AUV-VITP/isonavi-rov/docs/isonavi_rov_report.tex

\documentclass[10pt,a4paper]{article}

\usepackage[margin=22mm]{geometry}
\usepackage{amsmath,amssymb}
\usepackage{graphicx}
\usepackage{booktabs}
\usepackage{longtable}
\usepackage{caption}
\usepackage{xcolor}
\usepackage{titlesec}
\usepackage{enumitem}
\usepackage{fancyhdr}
\usepackage{siunitx}
\usepackage[hidelinks]{hyperref}

\newcommand{\INR}[1]{Rs.\,#1}

\definecolor{accent}{HTML}{16407A}

\titleformat{\section}{\normalfont\Large\bfseries\color{accent}}{\thesection}{0.6em}{}
\titleformat{\subsection}{\normalfont\large\bfseries}{\thesubsection}{0.6em}{}

\pagestyle{fancy}
\fancyhf{}
\lhead{\small\color{accent}isonavi-rov \textbar{} Technical Design Report}
\rhead{\small\thepage}
\renewcommand{\headrulewidth}{0.4pt}

\renewcommand{\topfraction}{0.92}
\renewcommand{\bottomfraction}{0.85}
\renewcommand{\textfraction}{0.06}
\renewcommand{\floatpagefraction}{0.80}
\setcounter{topnumber}{3}
\setcounter{bottomnumber}{2}
\setcounter{totalnumber}{5}

\captionsetup{font=small,labelfont={bf,color=accent}}
\sisetup{detect-all}
\setlist{nosep,leftmargin=1.4em}

\input{rov_metrics.tex}

\newcommand{\keyfig}[3]{%
  \IfFileExists{#1}{%
    \begin{figure}[htbp]\centering
    
    \caption{#2}\label{#3}
    \end{figure}}{}}
\newcommand{\widthfig}[4]{%
  \IfFileExists{#1}{%
    \begin{figure}[htbp]\centering
    
    \caption{#2}\label{#3}
    \end{figure}}{}}

\begin{document}

\begin{titlepage}
\centering
\vspace*{0.35cm}
{\color{accent}\rule{\linewidth}{1.2pt}}\\[4mm]
{\Huge\bfseries isonavi-rov}\\[3mm]
{\Large A tethered, piloted underwater vehicle for confined water}\\[2mm]
{\color{accent}\rule{\linewidth}{1.2pt}}\\[6mm]

{\large Technical Design Report}\\[3mm]
{\normalsize Vehicle, power, safety, vision and pilot assist, and the simulation that sizes them}\\[8mm]

\begin{minipage}{0.86\linewidth}
\small
\textbf{Summary.} This report covers the simulation study of isonavi-rov on
its parametric reference vehicle: a
\SI{\mmass}{\kilo\gram}, \mlenoverall{} by \mbeam{} by \mheight{}~cm open frame
ROV, powered and controlled over a \SI{50}{\metre} tether, that threads a
\SI{1}{\metre} gate, finds and touches a coloured target in an unlit pool by
its own light, and flies a three section walled maze. The reference carries
eight vectored thrusters; the build carries six on six ESCs, and the layout is
a parameter of the budget, so every result here reruns on it.

The design is closed by analysis rather than chosen: mass, buoyancy and
trim are solved from a component list and checked against a CAD model built
from the same list; the power path is sized to a governed peak; and the
thrusters are matched to their propeller. Four pilot modes, manual,
assisted, the camera alone in the lateral loop, and shared, where the
camera's correction and the pilot's stick are blended by the error each has,
are flown through the course in simulation with a modelled human operator,
across water clarities and forty random course layouts, and scored on
contacts, target and time. The vehicle-side software then runs on a hardware-in-the-loop
bench over a framed, CRC-checked protocol, and reproduces the simulation.
\end{minipage}

\vspace{3mm}
\IfFileExists{../simulation/vehicle/isonavi_rov_hero.png}{}{}

\vspace{3mm}
\begin{minipage}{0.94\linewidth}
\centering\footnotesize
\renewcommand{\arraystretch}{1.05}
\begin{tabular}{@{}lc@{\hspace{7mm}}lc@{}}
\toprule
Mass, envelope & \SI{\mmass}{\kilo\gram}, \mlenoverall{} x \mbeam{} x \mheight{} cm &
Contacts per run, murky: assist, shared & \mrefassistmurkycontacts{}, \mrefsharedmurkycontacts{} \\
Surge force, one unit lost & \SI{\msurgelost}{\newton} &
Contacts per run, turbid: assist, shared & \mrefassistmidcontacts{}, \mrefsharedmidcontacts{} \\
Governed input, peak current & \SI{\mcapw}{\watt}, \SI{\mpeakamps}{\ampere} &
Target colour, \SI{1}{\metre}, murky water & \midmurkyone{}\,\% \\
Link loss to zero thrust & \SI{\mholdtime}{\second} &
Cost, vehicle with tether and surface & \INR{\mcostbuild} \\
\bottomrule
\end{tabular}
\end{minipage}

\vfill
{\small Every number in this report is generated from the result files\\
by a script in the repository that accompanies it\\[1mm]
\texttt{github.com/AUV-VITP/isonavi-rov}}
\end{titlepage}

\tableofcontents
\newpage

% ======================================================================
\section{Requirements}

The vehicle is designed against the following, which together describe a
piloted pool task: pass a submerged gate without touching it, identify a
target by colour in an unlit pool and touch it, and fly a walled maze while
touching as little as possible.

\begin{table}[htbp]\centering\small
\begin{tabular}{@{}lll@{}}
\toprule
Requirement & Value & How it is met \\
\midrule
Mass in air & below \SI{35}{\kilo\gram}, target below \SI{20}{\kilo\gram} & \SI{\mmass}{\kilo\gram}, Section~\ref{sec:budget} \\
Envelope & target below 75 x 65 x 60 cm & \mlenoverall{} x \mbeam{} x \mheight{} cm over the probe \\
Power & 230 V 50 Hz mains, fused & \msupplyv{} V supply, \SI{\mfuse}{\ampere} fuse, Section~\ref{sec:power} \\
Emergency stop & external kill switch & four layer chain, Section~\ref{sec:safety} \\
Tether & about \SI{50}{\metre} & power pair and Cat5e, neutrally buoyant \\
Pool & 20 x 10 m, 0.6 to 1.8 m deep & arena model, Section~\ref{sec:arena} \\
Gate & \SI{1}{\metre} clear opening & beam \SI{\mbeam}{\centi\metre} \\
Maze walls & up to \SI{1.5}{\metre} high, covered passage & arena model \\
Leaks and pollution & none & no battery aboard, sealed hull, leak probes \\
Compressed gas, lasers & none carried & not applicable \\
\bottomrule
\end{tabular}
\caption{Design requirements and where each is closed.}\label{tab:req}
\end{table}

% ======================================================================
\section{Vehicle}\label{sec:budget}

\keyfig{../simulation/vehicle/isonavi_rov_views.png}{General arrangement, from the CAD model
built out of the solved budget. Four horizontal thrusters canted at 45 degrees
give surge, sway and yaw; four vertical thrusters give heave, roll and pitch.
The vehicle can move sideways without turning, which is how it crosses the
slalom without widening its swept path.}{fig:views}

\subsection{Mass, buoyancy and trim are solved}

Every component is listed with a mass, a displaced volume and a station
(\texttt{simulation/vehicle/rov.py}). Three things are then solved rather than chosen: the
foam volume, so the vehicle floats \SI{\mnetbuoy}{\newton} positive and rises
if power is lost; the lead ballast, so the centre of gravity sits
\SI{\mbg}{\milli\metre} below the centre of buoyancy and the vehicle rights
itself; and the foam station, so it floats level (trim offset
\SI{\mtrim}{\milli\metre}). The result is \SI{\mmass}{\kilo\gram} and
\SI{\mdisplaced}{\litre} with \SI{\mfoam}{\litre} of foam and
\SI{\mballast}{\kilo\gram} of lead.

\subsection{The CAD checks the budget}

\texttt{simulation/vehicle/rov\_cad.py} builds the \mcadparts{}-part assembly from the solved
budget and checks it three ways. The displaced volume of each group as built
agrees with the budget: buoyancy \SI{\mcadbuoybuilt}{\litre} and hull
\SI{\mcadhullbuilt}{\litre} exactly, the rest to within items not modelled as
solids (fasteners, cables, the depth sensor). The assembly fits a
\mcadenvl{} x \mcadenvb{} x \mcadenvh{} cm box. And every part is tested
against every other for overlap: \mcadclash{} pairs overlap, the closest
thruster duct clears a side plate by \SI{\mcadplate}{\milli\metre}, and the
foam blocks \SI{\mcadoutflow}{\milli\litre} of the worst vertical thruster's
outflow.

The check earned its place. The first build found the vertical ducts
touching the side plates, which moved their station inboard by
\SI{15}{\milli\metre}; displaced volumes for the ducts, skids and end caps
that the budget had underestimated; a probe that protrudes
\SI{6}{\centi\metre} past the frame and therefore had to be in the contact
model; lamps that overlapped the front horizontal ducts; and a kill switch
inside the foam. Each was fixed in the budget, not only in the drawing, and
the simulation re-run.

\subsection{Hydrodynamics and thrust}

Damping and added mass are scaled from the tank-identified coefficients of
the BlueROV2 Heavy, an open frame vehicle of the same class, by projected area and
displaced volume. With \mthrustmax{}~N thrusters the vehicle makes
\SI{\msurgefull}{\newton} in surge and sway and \SI{\mheavefull}{\newton} in
heave, for \SI{\mspeedfull}{\metre\per\second} ahead.

The course is flown at \SI{\mopsspeed}{\metre\per\second}. There, the tether
is a third of the load: \mtrail{} m of trailing tether adds
\SI{\mtetherdrag}{\newton} to the frame's \SI{\mframedrag}{\newton}. With any
one thruster lost, a linear program over the surviving seven still makes
\SI{\msurgelost}{\newton} with zero net moment, a margin of \mopsmargin{} over
that load. That margin is what set the thrust target at \mthrustmax{}~N.

The tether drag acts where the tether is terminated, so the termination sits
at the height of the centre of gravity, on a post between the two rear cross
members: \SI{\mtowarm}{\milli\metre} from the CG height, the drag at operating
speed holds \mtowpitch$^\circ$ of pitch against the righting moment of the
BG, which the attitude hold barely has to answer.

The horizontal thrusters sit \SI{\mthrhz}{\milli\metre} below the CG, so
surge thrust pitches the vehicle: at the full surge envelope that is
\SI{\msurgepitchmoment}{\newton\metre} against a righting moment that peaks at
$m g\,BG$, and uncorrected it would hold the vehicle about \msurgepitchdeg{}
degrees nose up. The allocation therefore takes every moment about the CG with
the thrusters at their real heights, and answers surge with the verticals; the
envelope above already pays for it. The python dynamics had left the heights
out until the Gazebo model (Section~\ref{sec:gazebo}), which places the
thrusters where the CAD has them, made the coupling visible.

\subsection{Thrusters, made in house}

Each thruster is a hobby outrunner run flooded, with a potted stator, in a
printed Kort duct with a \SI{76}{\milli\metre} three blade propeller. The
motor is matched to the propeller rather than picked by habit
(\texttt{simulation/vehicle/thruster.py}): at the bench point the propeller turns at about
\mkvrpm{}~rpm, far below where a high KV winding wants to run, so the motor
works at low speed and high torque. A 1000~KV winding would carry
\SI{\mkvthousandphase}{\ampere} of phase current, past 80\,\% of a
\SI{30}{\ampere} controller. The \mkvchosen{}~KV winding carries
\SI{\mkvphase}{\ampere} and draws \SI{\mkvinput}{\watt}, and its motor and
propeller efficiencies together reproduce the drive efficiency the power path
was sized on. The propellers are printed in left and right hand pairs so their
reaction torques cancel; the dynamics leave propeller torque out, which holds
only with them paired.

% ======================================================================
\section{Power and tether}\label{sec:power}

A 48 V mains supply at the poolside is set to \SI{\msupplyv}{\volt}, inside
its 43 to 55 V adjustment and below its over-voltage threshold, and that runs
down two paralleled \SI{2.5}{\milli\metre\squared} cores per leg (loop
resistance \SI{\mloopohm}{\ohm}) to two converters aboard that feed the
thruster rail. The higher voltage carries the same power on less current, and
tether loss goes with the square of the current. There is no battery on the
vehicle.

All eight thrusters at full draw \SI{\muncapped}{\watt}, which would need a
\SI{40}{\ampere} fuse and a supply to match. That is not a design point, so a
governor in the allocator caps input at \SI{\mcapw}{\watt}. Propeller power
from momentum theory is homogeneous of degree $3/2$ in thrust, so scaling
every thruster by $k$ scales the total by $k^{3/2}$ and the $k$ that meets the
cap is exact in one step. At the cap all eight together still make
\SI{\mcapthrust}{\newton} each, the current is \SI{\mpeakamps}{\ampere}, the
converters see \SI{\mvinpeak}{\volt} against a \SI{36}{\volt} floor, and the
tether dissipates \SI{\mtetherloss}{\watt}. The surface supply is
\SI{\msupplyw}{\watt} and the main fuse \SI{\mfuse}{\ampere}, at 1.25 times
the governed peak current. Fifty metres is inside the \SI{100}{\metre} reach
of plain Ethernet, so the data pair is Cat5e with no modem.

At the governed peak the converters lose \SI{\mconvloss}{\watt} as heat inside
the sealed acrylic tube, where still air and the acrylic wall both conduct
poorly. An aluminium plate carries it from the converters to the rear end
cap, which is machined aluminium and in the water.

% ======================================================================
\section{Safety chain}\label{sec:safety}

Four layers, each able to stop the thrusters on its own:
\begin{enumerate}
\item a fused mains supply with an emergency stop on its output;
\item an external magnet kill switch on the vehicle that opens the thruster rail;
\item the supervisor on the flight computer, which zeroes thrust on a kill, a
leak, or \SI{\mholdtimeout}{\second} without a pilot packet, and latches the
kill and leak states;
\item the ESP32, whose firmware drops every channel to neutral if the flight
computer goes quiet.
\end{enumerate}
The vehicle floats positive, so zero thrust is the safe state: from the
deepest point of the pool it rises unpowered. On the hardware-in-the-loop
bench (Section~\ref{sec:hil}) a \SI{10}{\second} loss of pilot packets put
the board in HOLD \SI{\mholdtime}{\second} after the last packet, one control
tick after the timeout, with zero thrust throughout and a rise of
\SI{\mholdrise}{\metre}; packets returning re-armed it. A kill latched on the
tick it arrived and held zero thrust for all \mkillticks{} ticks that
followed, through continuing pilot traffic.

% ======================================================================
\section{Arena and camera}\label{sec:arena}

\subsection{Arena}

The pool is \SI{20}{\metre} by \SI{10}{\metre}, its floor sloping from
\SI{0.6}{\metre} to \SI{1.8}{\metre}. The course is a gate of two posts and a
crossbar with a \SI{1}{\metre} opening; four balloons of different colours on
a line, one of which is the target; and a three section maze, a straight
corridor, a slalom between posts, and a covered passage, with walls up to
\SI{1.5}{\metre} high. Placement is parametric, and the results are reported
both for a reference layout and for forty layouts drawn at random. Each
element carries a signed distance function, and the hull and probe are
sampled as points, so a contact is any sample on or inside an element.

\subsection{Camera image formation}

In an unlit pool the only light is what the vehicle carries. Per pixel and
per colour channel, with $c$ the attenuation coefficient, $\beta$ the volume
backscatter coefficient, $\rho$ the surface albedo, $t$ the range along the
ray and $r_l$ the lamp to point range,
\begin{align*}
L &= \frac{\rho}{\pi} \sum_{\text{lamps}} I_0\, b(\theta) \cos i\, \frac{e^{-c r_l}}{r_l^2}\, e^{-c t}, &
B &= \int_0^t \beta \sum_{\text{lamps}} I_0\, b(\theta_s) \frac{e^{-c r_l(s)}}{r_l(s)^2}\, e^{-c s}\, ds .
\end{align*}
Red is absorbed several times faster than blue, so colour fails before
detection does, and the backscatter integral is evaluated along every ray, so
lamp placement shows in the image the way it does in a real one. Water clarity
is set by the scattering coefficient $b$: $0.05$ per metre for a clear pool,
$0.4$ for a turbid one and $1.0$ for murky water.

\keyfig{../simulation/results/figures/r3_camera_views.png}{The onboard camera
at the same pose in three water clarities, rendered by the camera model. In
murky water the balloons are still there; their colour is not.}{fig:cam}

% ======================================================================
\section{Vision}

\subsection{Target colour, without training data}

A fixed colour threshold works at one range in one water and nowhere else, so
the target finder undoes the water instead. It removes the backscatter veil,
segments what remains into round blobs, takes range from apparent size
against the known target radius, multiplies each channel by $e^{2cr}$ to undo
the two way attenuation at that range, and matches the corrected chromaticity
to the nearest reference. A blob whose size implies a range the lamps cannot
light is speckle and is rejected; left in, the correction at that range turns
it any colour.

With the lamps as built, \SI{0.18}{\metre} either side of the lens, the target
colour is identified at \SI{1}{\metre} in \midclearone{}, \midmidone{} and
\midmurkyone{}\,\% of frames in clear, turbid and murky water, and at
\SI{1.5}{\metre} in \midclearonehalf{}, \midmidonehalf{} and
\midmurkyonehalf{}\,\%. Lamp placement matters: at \SI{1.5}{\metre} in turbid
water, lamps \SI{0.10}{\metre} off the lens identify \mlampnarrowmid{}\,\% and
lamps as built \mlampbuiltmid{}\,\%. The operating rule that follows is to
close to about a metre before committing to a colour.

\keyfig{../simulation/results/figures/r2_target_identification.png}{Target
colour identified correctly against range, by water clarity and lamp
placement, from rendered frames at jittered poses.}{fig:id}

\subsection{Where the vehicle is on the course, from the image}

The camera-alone and shared modes measure the vehicle's position across the
course from each frame at \SI{5}{\hertz}, in \texttt{vision.}\allowbreak\texttt{CourseEstimator}:
\begin{itemize}
\item \textbf{gate and obstacles}: posts are found as narrow bright columns.
With the distance to the post known, each bearing, rotated by the IMU heading,
gives the lateral offset, and an object elsewhere in the frame is rejected by
its bearing. One offset has to explain every column at once, so a far post is
not paired with a near one. At the gate both posts must be in the frame and
each must have its own column; otherwise the frame gives no measurement.
Without that rule, once one post had left the edge of the frame close to the
gate, the fit took a lone column far beyond it for the missing post and
steered the vehicle towards the post it could no longer see; in murky water
that was behind every gate contact traced in the random layouts;
\item \textbf{target}: bearing and range from size of the detection of the
target colour;
\item \textbf{corridor}: a lamp-lit wall dims as the square of its distance,
so the log ratio of left to right wall brightness is
$s = 2 \ln\frac{w/2 + y}{w/2 - y}$ for an offset $y$ in a corridor of width
$w$. Inverted, $y = \frac{w}{2}\tanh(g s/4)$ plus a heading term; the gain
and heading term are fitted per water clarity on rendered frames from random
layouts and tested on held-out frames.
\end{itemize}
Every estimator is tested on rendered frames called exactly as the closed loop
calls it; the gate frames come from random layouts, so what lies beyond the
gate is in the test. These held-out errors are also what the shared mode
weights the camera by.

\begin{table}[htbp]\centering\small
\begin{tabular}{@{}lccc@{}}
\toprule
RMS lateral error, mm & $b = 0.05$ & $b = 0.4$ & $b = 1.0$ \\
\midrule
Corridor, straight section & \mwallclearstraight & \mwallmidstraight & \mwallmurkystraight \\
Corridor, covered passage & \mwallclearpassage & \mwallmidpassage & \mwallmurkypassage \\
Corridor walls, slalom section & \mwallclearobstacles & \mwallmidobstacles & \mwallmurkyobstacles \\
Posts, slalom section & \mpostsclear & \mpostsmid & \mpostsmurky \\
Gate posts at \SI{1}{\metre} & \mgateclearone & \mgatemidone & \mgatemurkyone \\
Target at \SI{1}{\metre} & \mtgtclearone & \mtgtmidone & \mtgtmurkyone \\
\bottomrule
\end{tabular}
\caption{Lateral position error of the course estimators on held-out rendered
frames. The slalom posts disturb the wall ratio, which is why that section
uses the posts. At the gate, a measurement comes back in \mgateclearoneavail,
\mgatemidoneavail{} and \mgatemurkyoneavail\,\% of frames at
\SI{1}{\metre}.}\label{tab:est}
\end{table}

% ======================================================================
\section{Pilot in the loop}

The vehicle is flown by a person looking at the camera feed, so the question
is what a pilot with a reaction time, video latency and an imperfect read of
the picture achieves, and how much the vehicle's own loops change that. The
operator is a crossover model: stick commands are a gain on the perceived
error plus a lead term, delayed by \SI{0.25}{\second} of reaction and
\SI{0.15}{\second} of video latency, with motor noise on the stick. The
pilot's read of the course degrades with range and with the two way
attenuation of the vehicle's own light over it.

\begin{description}
\item[manual] sticks map to thrust; the pilot also flies depth and attitude,
which on a positively buoyant vehicle is constant work.
\item[assist] depth hold from the pressure sensor and heading and attitude
hold from the IMU; vertical speed is taken from the depth signal, not from
the simulator. The pilot steers in the horizontal plane only.
\item[camera] the assist loops plus the course estimators in the lateral loop,
rendered from the camera model every \SI{0.2}{\second}. Open water legs, with
nothing to see or hit, are held on heading, and progress along the course is
taken as known. On the vehicle the ROS~2 layer runs the corridor part of this
mode, which needs only the corridor width; gate and target guidance need the
course geometry, which the pilot supplies.
\item[shared] the assist loops, with the pilot's lateral command blended with
the camera's, each weighted by the inverse of its error variance: the
estimator's held-out error for that section and range (Table~\ref{tab:est})
against the spread of the pilot's read at that range and clarity. In clear
water close in, the pilot's read is the better one and the camera's share is
small; in murky water at range, the reverse. The camera's share is formed
aboard and does not wait for the video delay, and a frame with no measurement
leaves the pilot's command alone.
\end{description}
The camera's estimate is differenced at the control rate, so its rate acts
in the tick a frame arrives. Smoothing it first with an alpha-beta tracker was
tried and added contacts in both camera modes: the estimate does carry frame
to frame noise, but the lag the tracker adds cost more than the noise it took
out. The ROS~2 pilot node differences the same way.
Runs are scored on what an observer records: contacts as events, the gate
passed clean or not, the right target touched with the probe or not, and time.

% ======================================================================
\section{Results}

\subsection{Reference layout}

\begin{table}[htbp]\centering\small
\begin{tabular}{@{}lccccc@{}}
\toprule
Mode, water & Finished & Gate clean & Right target & Contacts per run & Time, s \\
\midrule
manual, $b = 0.05$ & \mrefmanualcleardone/\mrefmanualclearn & \mrefmanualcleargate & \mrefmanualclearhit & \mrefmanualclearcontacts{} $\pm$ \mrefmanualclearcontactsd & \mrefmanualcleartime \\
manual, $b = 0.4$ & \mrefmanualmiddone/\mrefmanualmidn & \mrefmanualmidgate & \mrefmanualmidhit & \mrefmanualmidcontacts{} $\pm$ \mrefmanualmidcontactsd & \mrefmanualmidtime \\
manual, $b = 1.0$ & \mrefmanualmurkydone/\mrefmanualmurkyn & \mrefmanualmurkygate & \mrefmanualmurkyhit & \mrefmanualmurkycontacts{} $\pm$ \mrefmanualmurkycontactsd & \mrefmanualmurkytime \\
assist, $b = 0.05$ & \mrefassistcleardone/\mrefassistclearn & \mrefassistcleargate & \mrefassistclearhit & \mrefassistclearcontacts{} $\pm$ \mrefassistclearcontactsd & \mrefassistcleartime \\
assist, $b = 0.4$ & \mrefassistmiddone/\mrefassistmidn & \mrefassistmidgate & \mrefassistmidhit & \mrefassistmidcontacts{} $\pm$ \mrefassistmidcontactsd & \mrefassistmidtime \\
assist, $b = 1.0$ & \mrefassistmurkydone/\mrefassistmurkyn & \mrefassistmurkygate & \mrefassistmurkyhit & \mrefassistmurkycontacts{} $\pm$ \mrefassistmurkycontactsd & \mrefassistmurkytime \\
camera, $b = 0.05$ & \mrefautocleardone/\mrefautoclearn & \mrefautocleargate & \mrefautoclearhit & \mrefautoclearcontacts{} $\pm$ \mrefautoclearcontactsd & \mrefautocleartime \\
camera, $b = 0.4$ & \mrefautomiddone/\mrefautomidn & \mrefautomidgate & \mrefautomidhit & \mrefautomidcontacts{} $\pm$ \mrefautomidcontactsd & \mrefautomidtime \\
camera, $b = 1.0$ & \mrefautomurkydone/\mrefautomurkyn & \mrefautomurkygate & \mrefautomurkyhit & \mrefautomurkycontacts{} $\pm$ \mrefautomurkycontactsd & \mrefautomurkytime \\
shared, $b = 0.05$ & \mrefsharedcleardone/\mrefsharedclearn & \mrefsharedcleargate & \mrefsharedclearhit & \mrefsharedclearcontacts{} $\pm$ \mrefsharedclearcontactsd & \mrefsharedcleartime \\
shared, $b = 0.4$ & \mrefsharedmiddone/\mrefsharedmidn & \mrefsharedmidgate & \mrefsharedmidhit & \mrefsharedmidcontacts{} $\pm$ \mrefsharedmidcontactsd & \mrefsharedmidtime \\
shared, $b = 1.0$ & \mrefsharedmurkydone/\mrefsharedmurkyn & \mrefsharedmurkygate & \mrefsharedmurkyhit & \mrefsharedmurkycontacts{} $\pm$ \mrefsharedmurkycontactsd & \mrefsharedmurkytime \\
\bottomrule
\end{tabular}
\caption{Course runs on the reference layout, 20 seeds per row.}\label{tab:ref}
\end{table}

Every run in every row finished, passed the gate clean and touched the right
target, so the rows differ in contacts and time. A pilot's contacts are set
by the water. In clear and turbid water a manual pilot averages under one
contact a run and the assist cuts that further, because the pilot no longer
flies depth and attitude. At $b = 1.0$ the pilot's read of the corridor fails
with the two way attenuation of the vehicle's own light, and contacts rise to
\mrefmanualmurkycontacts{} manual and \mrefassistmurkycontacts{} assisted,
with a spread as large as the mean; over the twenty assisted runs,
\mrefassistmurkywallhits{} contacts are with the maze walls and
\mrefassistmurkyposthits{} with the slalom posts.

The camera alone behaves the other way: \mrefautoclearcontacts{},
\mrefautomidcontacts{} and \mrefautomurkycontacts{} contacts a run at the
three clarities, with a small spread, because its error comes from the
estimators, which depend little on clarity, and not from a read that fails
with range. Its contacts are at the first two slalom posts. The gap beside a
post is \SI{\mslalomgap}{\centi\metre}, which leaves the
\SI{\mbeam}{\centi\metre} beam \SI{\mslalomside}{\milli\metre} a side when
centred, and there the wall ratio, which assumes two plain walls, is
disturbed by the posts (\SI{\mwallmidobstacles}{\milli\metre} RMS at
$b = 0.4$ against \SI{\mwallmidstraight}{\milli\metre} in the straight
section), and the post fit is available in \mpostsmidavail\,\% of frames.

The shared mode takes the better of the two wherever it is on the course.
Paired seed by seed against the assist, its contacts a run differ by
$\mrefcleardiffassist \pm \mrefcleardiffassistse$ in clear water,
$\mrefmiddiffassist \pm \mrefmiddiffassistse$ in turbid water and
$\mrefmurkydiffassist \pm \mrefmurkydiffassistse$ in murky water (mean
and standard error): no worse where the pilot can see, and in murky water the
wall contacts all but go (\mrefsharedmurkywallhits{} over twenty runs). What
remains, in every mode that flies the course well, is the first two slalom
posts.

\keyfig{../simulation/results/figures/r1_course_tracks.png}{Tracks of one seed
in each mode, in turbid and murky water; auto is the camera alone. Crosses
mark contacts.}{fig:tracks}

\subsection{Random layouts}

\begin{table}[htbp]\centering\small
\begin{tabular}{@{}lccccc@{}}
\toprule
Mode, water & Finished & Gate clean & Right target & Contacts per run & Time, s \\
\midrule
manual, $b = 0.4$ & \mlaymanualmiddone/\mlaymanualmidn & \mlaymanualmidgate & \mlaymanualmidhit & \mlaymanualmidcontacts{} $\pm$ \mlaymanualmidcontactsd & \mlaymanualmidtime \\
manual, $b = 1.0$ & \mlaymanualmurkydone/\mlaymanualmurkyn & \mlaymanualmurkygate & \mlaymanualmurkyhit & \mlaymanualmurkycontacts{} $\pm$ \mlaymanualmurkycontactsd & \mlaymanualmurkytime \\
assist, $b = 0.4$ & \mlayassistmiddone/\mlayassistmidn & \mlayassistmidgate & \mlayassistmidhit & \mlayassistmidcontacts{} $\pm$ \mlayassistmidcontactsd & \mlayassistmidtime \\
assist, $b = 1.0$ & \mlayassistmurkydone/\mlayassistmurkyn & \mlayassistmurkygate & \mlayassistmurkyhit & \mlayassistmurkycontacts{} $\pm$ \mlayassistmurkycontactsd & \mlayassistmurkytime \\
camera, $b = 0.4$ & \mlayautomiddone/\mlayautomidn & \mlayautomidgate & \mlayautomidhit & \mlayautomidcontacts{} $\pm$ \mlayautomidcontactsd & \mlayautomidtime \\
camera, $b = 1.0$ & \mlayautomurkydone/\mlayautomurkyn & \mlayautomurkygate & \mlayautomurkyhit & \mlayautomurkycontacts{} $\pm$ \mlayautomurkycontactsd & \mlayautomurkytime \\
shared, $b = 0.4$ & \mlaysharedmiddone/\mlaysharedmidn & \mlaysharedmidgate & \mlaysharedmidhit & \mlaysharedmidcontacts{} $\pm$ \mlaysharedmidcontactsd & \mlaysharedmidtime \\
shared, $b = 1.0$ & \mlaysharedmurkydone/\mlaysharedmurkyn & \mlaysharedmurkygate & \mlaysharedmurkyhit & \mlaysharedmurkycontacts{} $\pm$ \mlaysharedmurkycontactsd & \mlaysharedmurkytime \\
\bottomrule
\end{tabular}
\caption{Forty random layouts per row: gate and target line placement, colour
order, which colour is the target, corridor width and slalom offsets all
vary.}\label{tab:lay}
\end{table}

Forty random layouts give the same picture, paired layout by layout. In
turbid water the shared mode is level with the assist
($\mlaymiddiffassist \pm \mlaymiddiffassistse$ contacts a run) and with the
manual pilot ($\mlaymiddiffmanual \pm \mlaymiddiffmanualse$); in murky water it makes
$\mlaymurkydiffassist \pm \mlaymurkydiffassistse$ against the assist and
$\mlaymurkydiffmanual \pm \mlaymurkydiffmanualse$ against the manual pilot,
and the assist's
\mlayassistmurkywallhits{} wall contacts fall to \mlaysharedmurkywallhits.
The gate was passed clean and the right target touched in every run of every
mode; a wrong balloon was touched on the way in a few times (in turbid water
\mlaymanualmidwrong{} manual and \mlaysharedmidwrong{} shared runs of
\mlaysharedmidn).

The operating rule that follows is to fly shared throughout. It asks the pilot
for no decision about when the water is too murky to trust their eyes: the
weighting makes that decision from the water clarity, which is a setting,
measured from camera frames in the pool before a run.

% ======================================================================
\section{Hardware in the loop}\label{sec:hil}

The bench splits the loop the way the vehicle is wired. The host is the world
and the surface station: it holds the pool, the true dynamics and the sensor
models, runs the pilot, and sends the sensor sample and the pilot packet each
tick. The board is the vehicle: it runs the hold loops, the allocation, the
governor and the supervisor on what it receives and returns the wrench the
thrusters produce. It never sees the course or the truth. The protocol is
a framed, CRC-checked link with two message types for the pilot
command and the supervisor report; a lost pilot packet is emulated by an
acknowledgement in its place, which keeps the bench deterministic.

Over the link, an assisted course finished in \SI{\mhiltime}{\second} against
\SI{\msimtime}{\second} in the pure simulation, with the same contact count
(\mhilcontacts) and a largest position difference of
\SI{\mhildev}{\metre} over \mhilticks{} ticks, which is re-allocation round
off and nothing else. The safety results are in Section~\ref{sec:safety}.
The board and the ESP32 actuator interface have run this protocol on
hardware; this bench ran over localhost, and the next step is the same run on
the boards.

% ======================================================================
\section{Gazebo model}\label{sec:gazebo}

The vehicle also runs in Gazebo Harmonic under ROS~2 Jazzy, with the same
nodes it flies on, against the pool world. Neither the model nor the world is
written by hand: \texttt{make\_model.py} builds the vehicle from the solved
budget and the CAD, and \texttt{make\_world.py} builds the pool from the arena
the course runs use, for the reference or any random layout.

\begin{itemize}
\item \textbf{mass and inertia}: from the budget, about the CG, which is the
link origin as it is the origin of the python dynamics; the eight propeller
links the thruster plugin needs are taken out of the hull's share, so the
totals are the budget's;
\item \textbf{added mass}: integrated implicitly by the physics engine. The
hydrodynamics plugin's own added mass is explicit, and diverges when the
heave added mass exceeds the dry mass, as it does here;
\item \textbf{buoyancy}: Gazebo integrates the volume of the collision shapes,
which are also what a post or a wall meets. The contact shapes are the parts
that can be met, at their real sizes, the side plates at the thickness that
leaves their pocketed volume; one shape that touches nothing carries the rest
of the budgeted volume, placed so the total and its centre are the budget's
displaced volume and centre of buoyancy;
\item \textbf{thrusters}: the stations and axes are checked against the
allocation matrix when the model is written. The plugin spins each propeller
by setting its joint speed; driving it through joint torque, the plugin's
default, twists the hull with the reaction;
\item \textbf{tether}: the course runs' tether drag, applied at the tow point
every physics step from inside Gazebo;
\item \textbf{depth}: from the pose with the depth cell's noise and rate.
Gazebo has no water pressure sensor; its air pressure sensor reads the
atmosphere.
\end{itemize}

\begin{table}[htbp]\centering\small
\begin{tabular}{@{}llc@{}}
\toprule
Case, open loop & Quantity & RMS difference \\
\midrule
Rise, zero thrust & depth & \SI{\mtwinrisez}{\milli\metre} \\
Heave, verticals pushing down & depth & \SI{\mtwinheavez}{\milli\metre} \\
Surge & position, speed & \SI{\mtwinsurgex}{\milli\metre}, \SI{\mtwinsurgeu}{\milli\metre\per\second} \\
Surge & pitch & \mtwinsurgepitch$^\circ$ \\
Roll, released at \ang{20} & roll & \mtwinrollroll$^\circ$ \\
Surge with the tether & position, speed & \SI{\mtwintetherx}{\milli\metre}, \SI{\mtwintetheru}{\milli\metre\per\second} \\
\bottomrule
\end{tabular}
\caption{The Gazebo model against the python dynamics, same thruster forces
from the same start, compared every \SI{20}{\milli\second}. The python
thrusters apply their command at once here, as Gazebo's do.}\label{tab:twin}
\end{table}

\keyfig{../simulation/results/figures/r4_gazebo_twin.png}{The Gazebo model
(dashed) against the python dynamics, open loop.}{fig:twin}

The two agree to well inside a millimetre in translation; roll differs most,
by a fraction of a degree over a swing of \mtwinrollspan$^\circ$. With the model
checked, \texttt{test\_sim.sh} flies the nodes on it: an assisted surge stick
moves the vehicle forward at its held depth, and silence on the pilot link
holds every thruster at zero. Gazebo renders the camera without water, with
no absorption or backscatter, so the vision results stay with the camera
model of Section~\ref{sec:arena}; the Gazebo camera is for the plumbing.

% ======================================================================
\section{Software}

\begin{itemize}
\item \texttt{simulation/isonavi}: arena, camera, vision, pilot, safety, with
the dynamics, sensors and geometry they build on;
\item \texttt{ros/isonavi\_rov\_ros}: ROS~2 nodes for the pilot assist, the
safety chain, the actuator interface and vision, each a thin wrapper over the
module the simulation verified. The pilot node runs the shared mode's blend in
the corridor with the same functions the simulation uses, from the worst wall
section's error and the pilot's read at \SI{1.5}{\metre}, the middle of the
operator model's look-ahead along a corridor leg: the camera's share is
\mrosweightclear, \mrosweightmid{} and \mrosweightmurky{} in clear, turbid and
murky water. Built under Jazzy and run end to end: with
the gamepad live the actuator node emits the expected pulse widths, and when
it stops the supervisor reports HOLD and every channel goes to neutral;
\item \texttt{ros/isonavi\_rov\_description}, \texttt{ros/isonavi\_rov\_gazebo}:
the Gazebo model and pool world, their generators, the tether and depth
adapters and the check of Section~\ref{sec:gazebo};
\item \texttt{hil}: the bench in Section~\ref{sec:hil};
\item \texttt{simulation/vehicle}: budget, CAD and its checks, thruster match, bill of materials.
\end{itemize}

% ======================================================================
\section{Cost}

Prices are in rupees including GST, each line with the basis it rests on
(\texttt{simulation/vehicle/rov\_bom.py}).

\begin{table}[htbp]\centering\small
\begin{tabular}{@{}lr@{}}
\toprule
Group & Rupees \\
\midrule
Propulsion, eight thrusters & \mcostpropulsion \\
Hull & \mcosthull \\
Frame, foam and ballast & \mcostframe \\
Electronics & \mcostelectronics \\
\midrule
Vehicle & \mcostvehicle \\
Tether & \mcosttether \\
Surface station & \mcostsurface \\
\midrule
Vehicle, tether and surface & \mcostbuild \\
Test equipment and practice pool time & \mcosttest \\
Contingency & \mcostcont \\
\midrule
\textbf{Total} & \textbf{\mcosttotal} \\
\bottomrule
\end{tabular}
\caption{Cost by group. \minhouselines{} of \mbomlines{} lines are made in
house: the thrusters, end caps, frame, buoyancy, lamp housings, kill switch,
thermal bridge, tether floats and the thrust rig.}\label{tab:cost}
\end{table}

% ======================================================================
\section{Verification and what remains}

Verified in simulation: the mass, buoyancy and trim budget against the CAD;
the thrust envelope with a unit lost; the power path at the governed peak;
target identification and the course estimators on rendered frames; the
course in four modes across water clarities and random layouts. Verified on
the bench: the vehicle-side software reproducing the simulation over the
link, and the safety chain under link loss and kill. Verified in Gazebo: the
vehicle model against the python dynamics, and the nodes flying it closed
loop.

What needs water, in order:
\begin{enumerate}
\item a thrust curve for every thruster on the rig before it is fitted,
against the \mthrustmax{}~N target;
\item a vacuum test of the sealed hull, then a dunk test;
\item trim in a tank, against the solved foam and ballast;
\item camera frames in the pool to calibrate the attenuation coefficient and
the corridor gain, which the simulation takes from its model;
\item pilot hours on a mock course, which also measure the pilot's read
error that the shared mode weights the camera against.
\end{enumerate}
The hydrodynamic coefficients are scaled from a reference vehicle rather than
measured, and the operator model stands in for a real pilot; both are
replaced by measurement in the steps above.

\end{document}
