AUV-VITP/isonavi-rov/cad/solidworks/ASSem/Gripper/gripper_012645.png

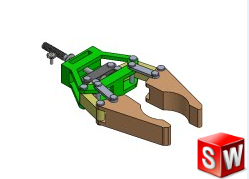
cad/solidworks/ASSem/Gripper/gripper_012645.png
