AUV-VITP/isonavi-rov/cad/solidworks/ASSem/Gripper/gripper_012656.png

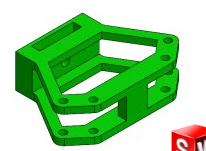
cad/solidworks/ASSem/Gripper/gripper_012656.png
