AUV-VITP/isonavi-rov/cad/solidworks/ASSem/Gripper/gripper_012730.png

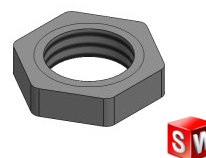
cad/solidworks/ASSem/Gripper/gripper_012730.png
