AUV-VITP/isonavi-rov/cad/solidworks/ASSem/Gripper/gripper_012734.png

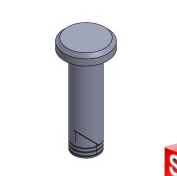
cad/solidworks/ASSem/Gripper/gripper_012734.png
