AUV-VITP/isonavi-rov/docs/media/architecture.jpeg

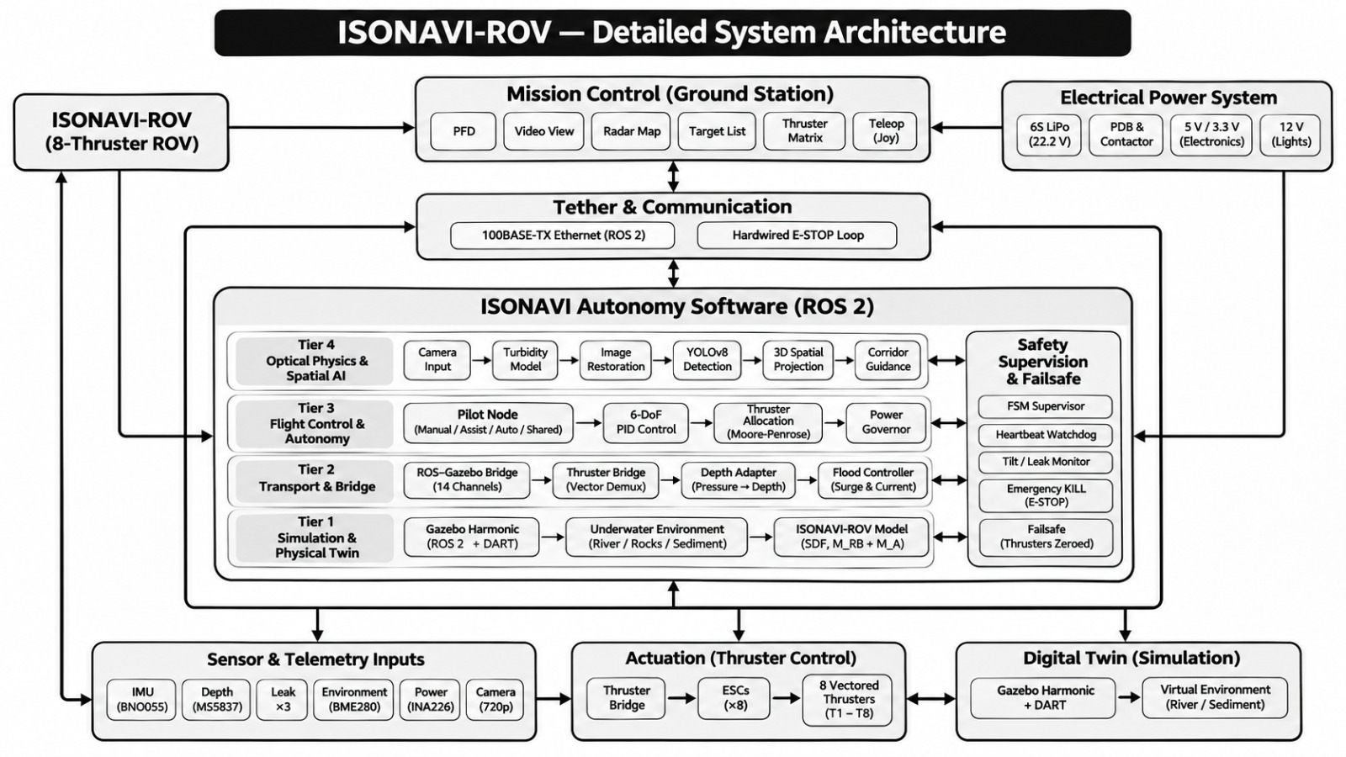
docs/media/architecture.jpeg
