AUV-VITP/isonavi-rov/docs/media/working_principle.jpeg

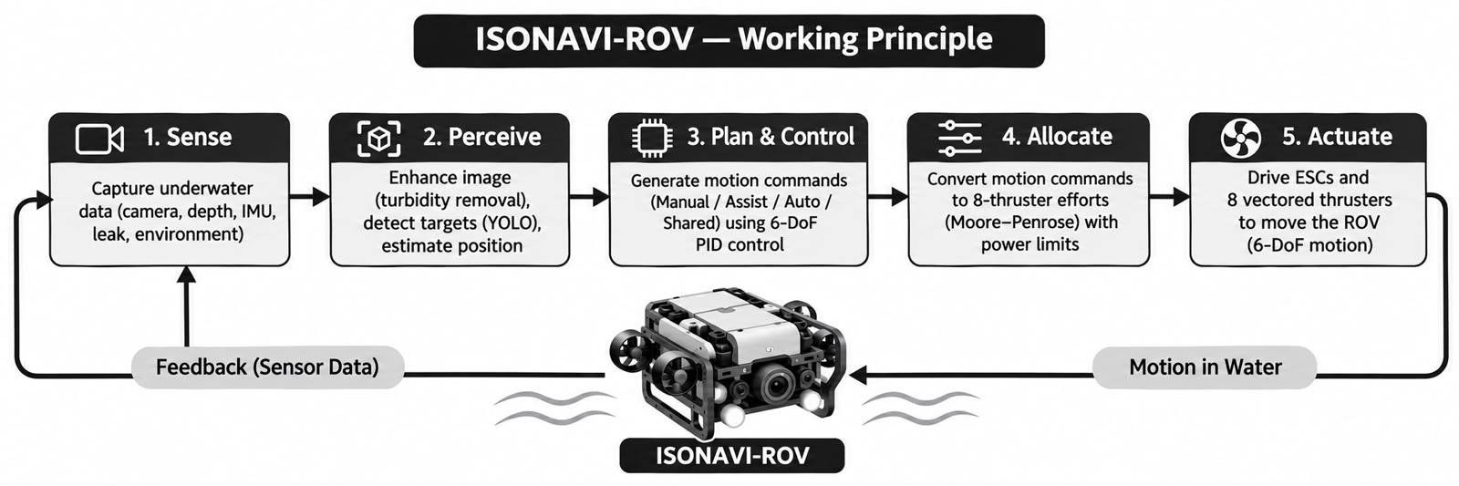
docs/media/working_principle.jpeg
