AUV-VITP/isonavi-rov/cad/solidworks/ASSem/BATT-SLED.SLDASM

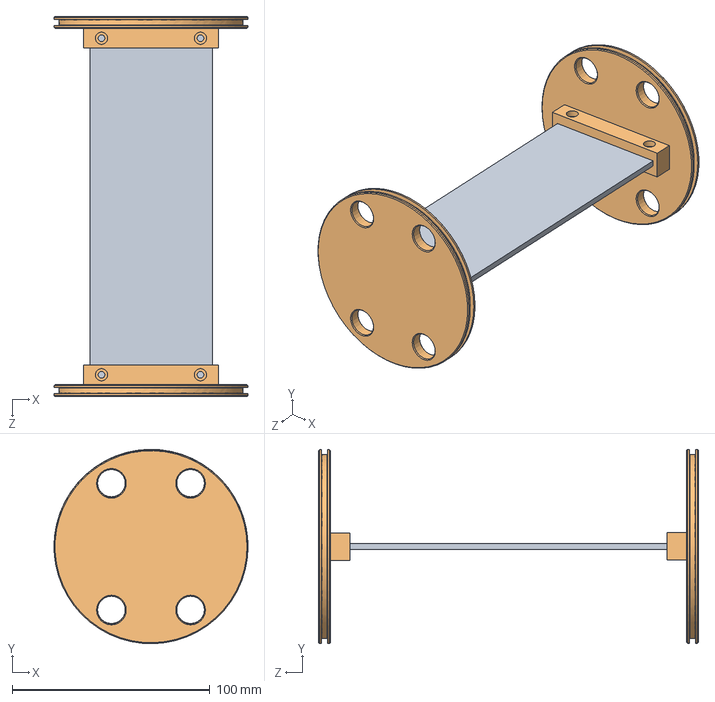
[picture p26: CAD file, 2026-11-10]
cad/solidworks/ASSem/BATT-SLED.SLDASM
98.0 x 98.2 x 192.0 mm
CAN-005_Disc - BATT x 2
CAN-004_Spine - BATT
