AUV-VITP/isonavi-rov/cad/solidworks/ASSem/MAIN.SLDASM

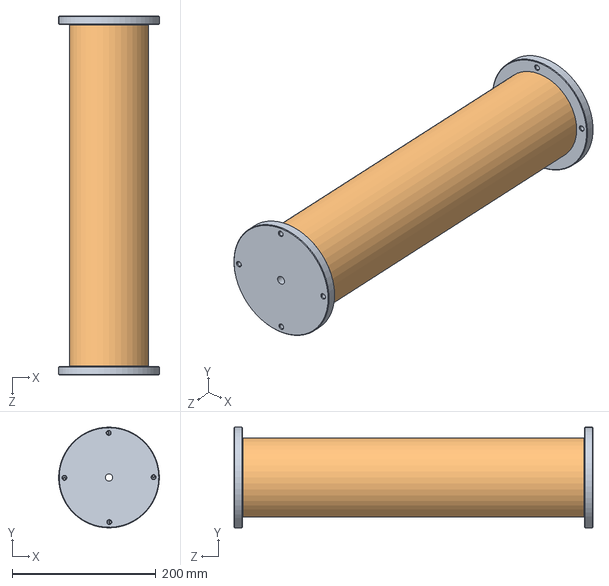
[picture p27: CAD file, 2026-11-10]
cad/solidworks/ASSem/MAIN.SLDASM
140.0 x 140.0 x 499.0 mm
CAN-001
CAN-003_Cap x 2
