AUV-VITP/isonavi-rov/cad/solidworks/ASSem/Gripper/Assem1.SLDASM

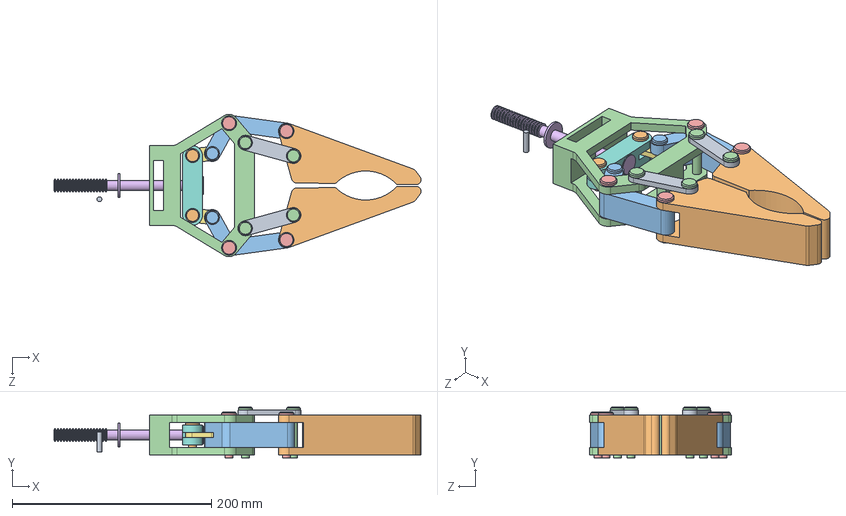
[picture p28: CAD file, 2026-11-10]
cad/solidworks/ASSem/Gripper/Assem1.SLDASM
368.2 x 51.0 x 143.0 mm
Bracket
Jaw Connctor x 2
Jaw x 2
connctor Big x 2
Slider
connctor small x 2
shift
pin2 x 4
pin3 x 4
pin4 x 2
pin1 x 2
crank
