AUV-VITP/isonavi-rov/cad/isonavi_rov.step

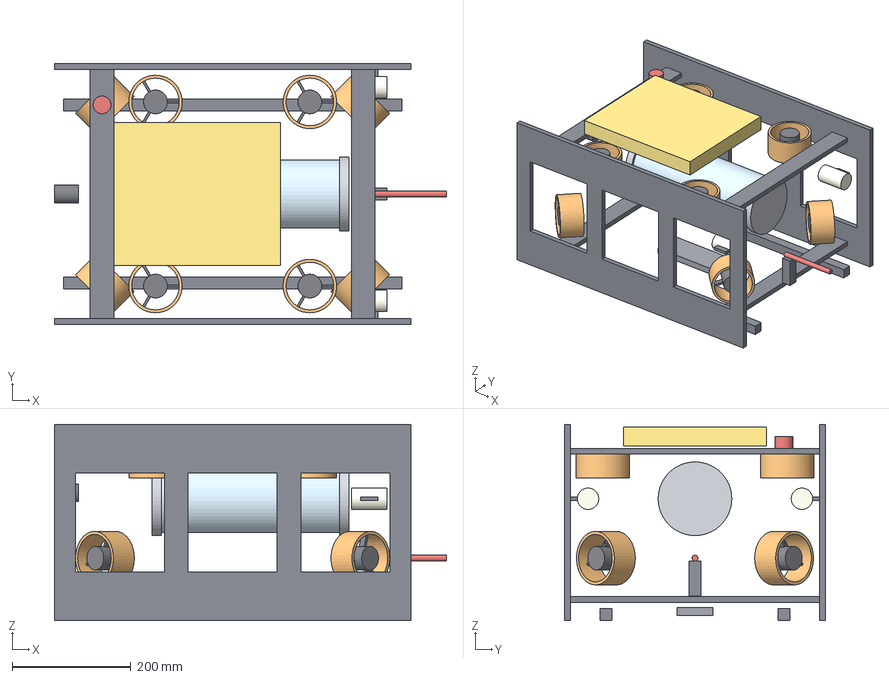
[picture p29: CAD file, 2026-10-23]
cad/isonavi_rov.step
660.0 x 440.0 x 330.0 mm
side plate port
side plate stbd
cross member 1
cross member 2
cross member 3
cross member 4
skid port
skid stbd
hull tube
end cap rear
end cap front
thruster h1 duct
thruster h1 pod
thruster h2 duct
thruster h2 pod
thruster h3 duct
thruster h3 pod
thruster h4 duct
thruster h4 pod
thruster v1 duct
thruster v1 pod
thruster v2 duct
thruster v2 pod
thruster v3 duct
thruster v3 pod
thruster v4 duct
thruster v4 pod
buoyancy foam
trim ballast
lamp port
lamp bracket port
lamp stbd
lamp bracket stbd
touch probe
probe bracket
kill switch
tether termination
