AUV-VITP/isonavi-rov/cad/solidworks/ASSem/Gripper/pin1.SLDPRT

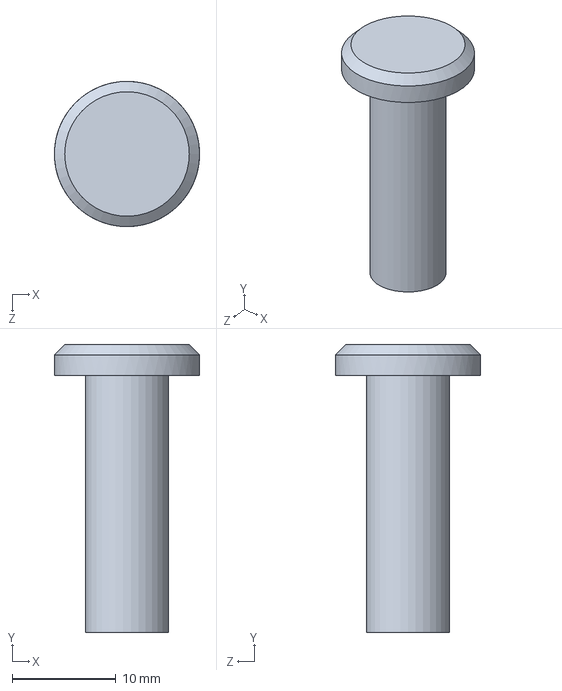
[picture p30: CAD file, 2026-11-10]
cad/solidworks/ASSem/Gripper/pin1.SLDPRT
14.0 x 27.8 x 14.0 mm
