AUV-VITP/isonavi-rov/ros/isonavi_rov_description/models/isonavi_rov/meshes/part_2.stl

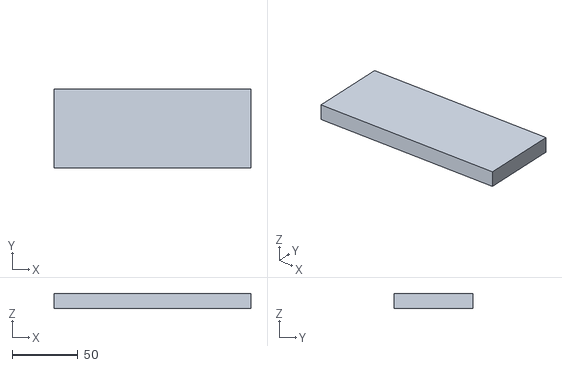
[picture p32: CAD file, 2026-10-25]
ros/isonavi_rov_description/models/isonavi_rov/meshes/part_2.stl
150.0 x 60.0 x 11.6
