AUV-VITP/isonavi-rov/cad/solidworks/ASSem/Gripper/Jaw Connctor.SLDPRT

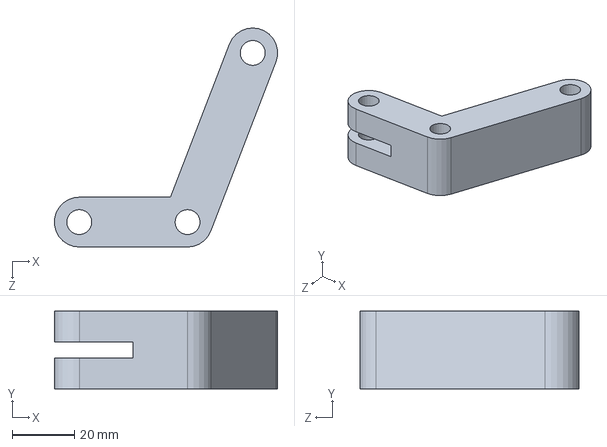
[picture p33: CAD file, 2026-11-10]
cad/solidworks/ASSem/Gripper/Jaw Connctor.SLDPRT
71.5 x 25.0 x 70.2 mm
