AUV-VITP/isonavi-rov/cad/solidworks/Parts/FRAME 1.SLDPRT

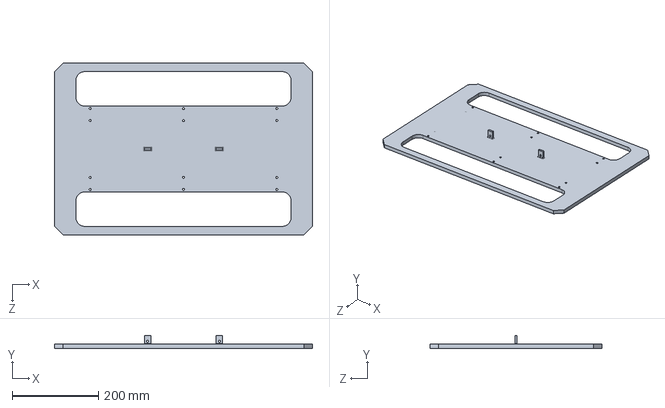
[picture p34: CAD file, 2026-11-10]
cad/solidworks/Parts/FRAME 1.SLDPRT
600.0 x 30.0 x 400.0 mm
