AUV-VITP/isonavi-rov/ros/isonavi_rov_description/models/isonavi_rov/meshes/part_7.stl

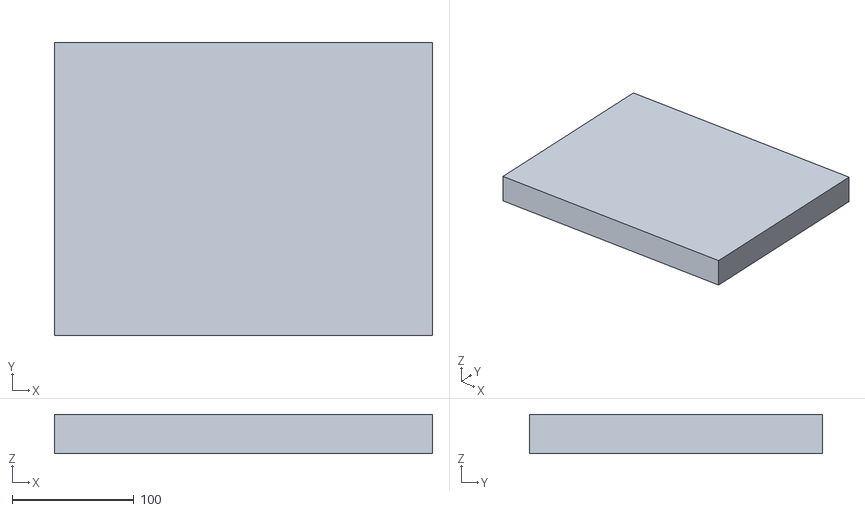
[picture p35: CAD file, 2026-10-25]
ros/isonavi_rov_description/models/isonavi_rov/meshes/part_7.stl
310.0 x 240.0 x 32.0
