AUV-VITP/isonavi-rov/cad/solidworks/ASSem/Gripper/shift.SLDPRT

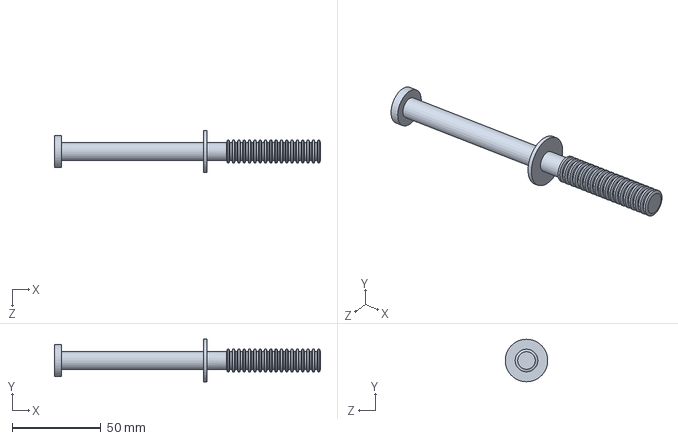
[picture p36: CAD file, 2026-11-10]
cad/solidworks/ASSem/Gripper/shift.SLDPRT
150.0 x 24.0 x 23.9 mm
