AUV-VITP/isonavi-rov/cad/solidworks/Parts/CAM-Mount.SLDPRT

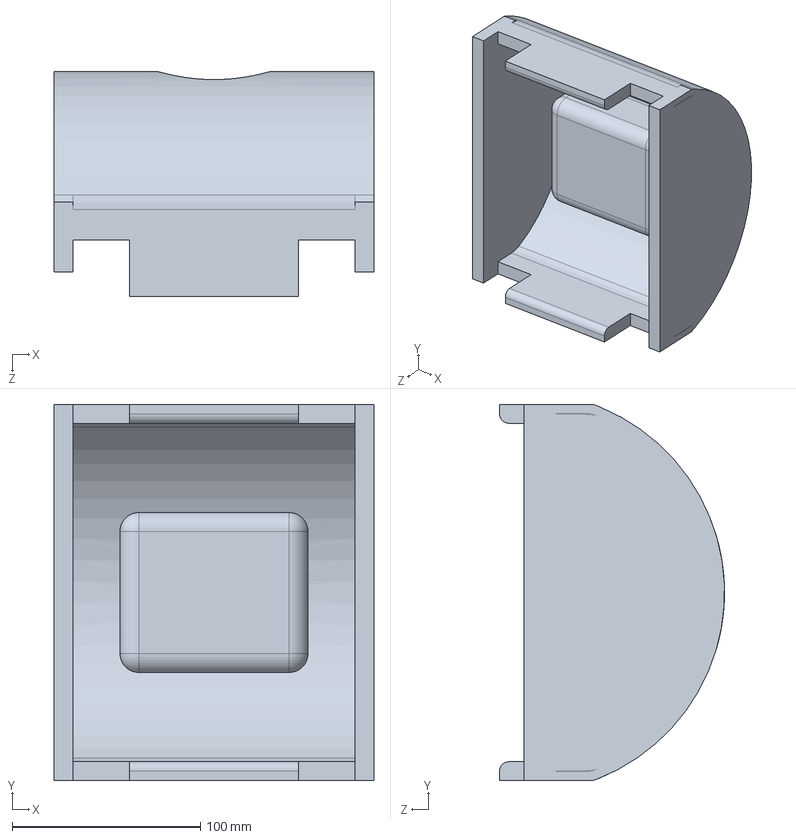
[picture p37: CAD file, 2026-11-10]
cad/solidworks/Parts/CAM-Mount.SLDPRT
170.0 x 200.0 x 119.7 mm
