AUV-VITP/isonavi-rov/ros/isonavi_rov_description/models/isonavi_rov/meshes/part_0.stl

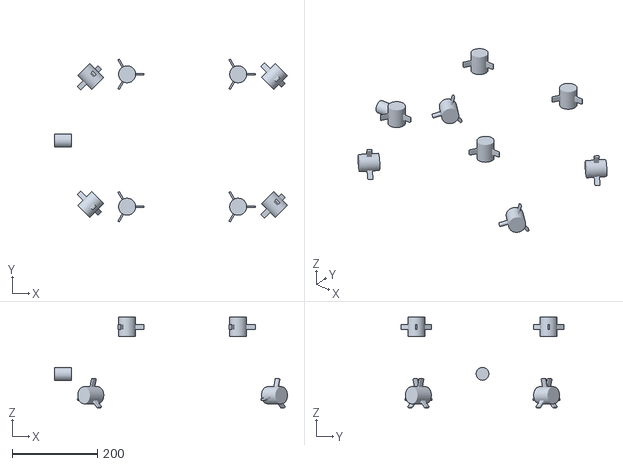
[picture p38: CAD file, 2026-10-25]
ros/isonavi_rov_description/models/isonavi_rov/meshes/part_0.stl
545.4 x 381.3 x 212.7
