AUV-VITP/isonavi-rov/cad/solidworks/ASSem/Gripper/Slider.SLDPRT

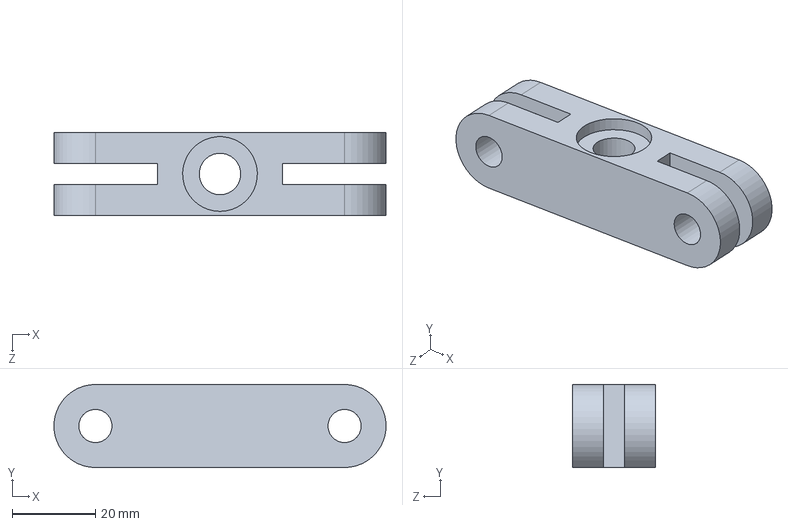
[picture p39: CAD file, 2026-11-10]
cad/solidworks/ASSem/Gripper/Slider.SLDPRT
79.9 x 20.0 x 20.0 mm
