AUV-VITP/isonavi-rov/cad/solidworks/Parts/CAN-002_Collar.SLDPRT

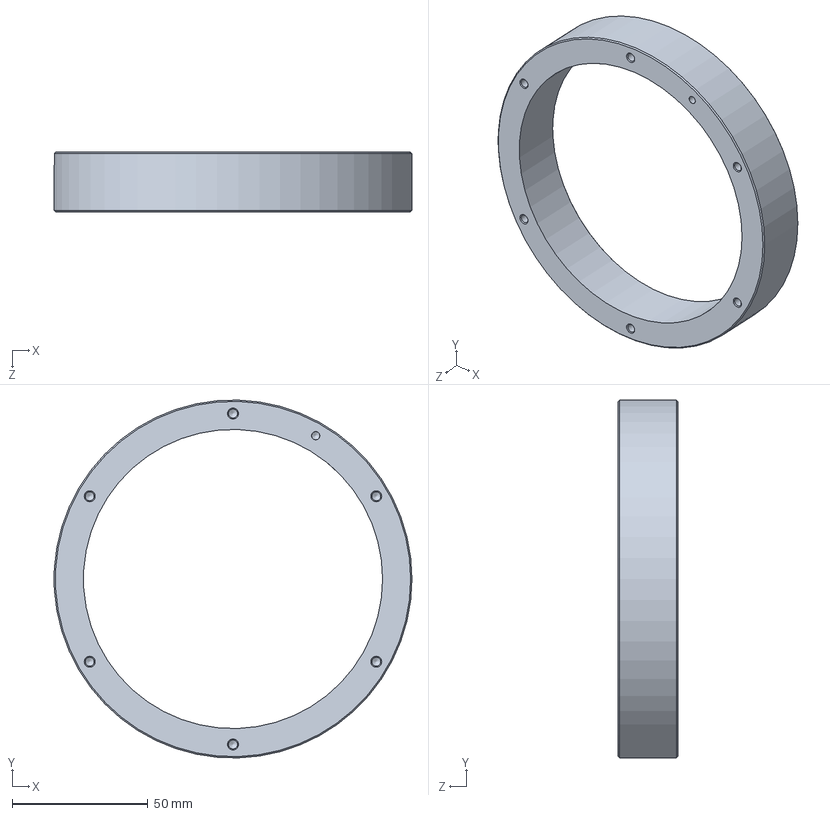
[picture p40: CAD file, 2026-11-10]
cad/solidworks/Parts/CAN-002_Collar.SLDPRT
132.0 x 131.9 x 22.0 mm
