AUV-VITP/isonavi-rov/cad/solidworks/ASSem/Gripper/pin2.SLDPRT

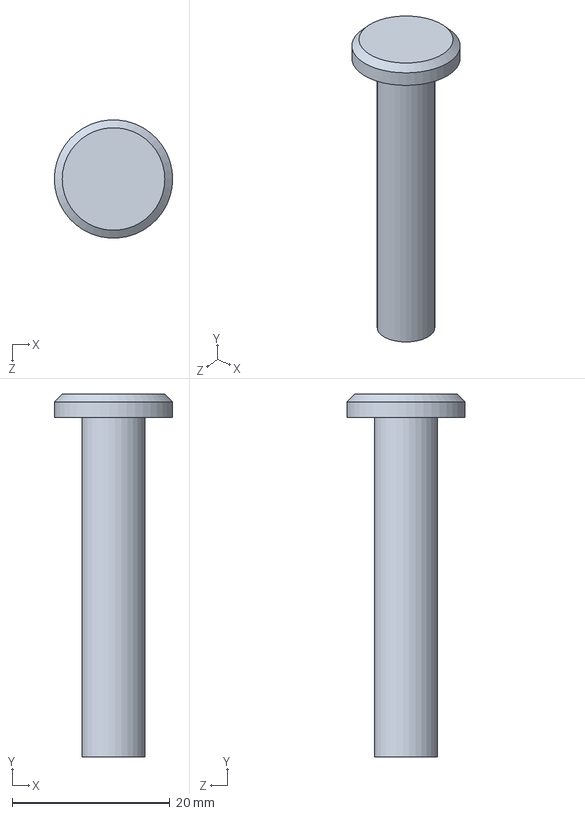
[picture p41: CAD file, 2026-11-10]
cad/solidworks/ASSem/Gripper/pin2.SLDPRT
15.0 x 46.0 x 15.0 mm
