AUV-VITP/isonavi-rov/cad/solidworks/Parts/CAN-005_Disc.SLDPRT

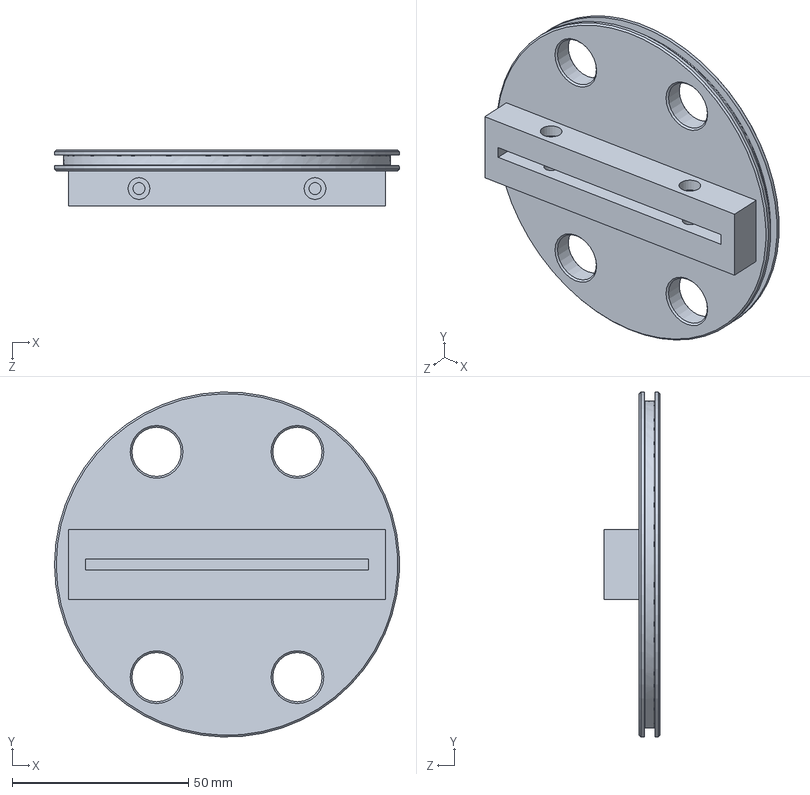
[picture p42: CAD file, 2026-11-10]
cad/solidworks/Parts/CAN-005_Disc.SLDPRT
98.0 x 98.0 x 16.0 mm
