AUV-VITP/isonavi-rov/cad/solidworks/Parts/Cann_Brackets.SLDPRT

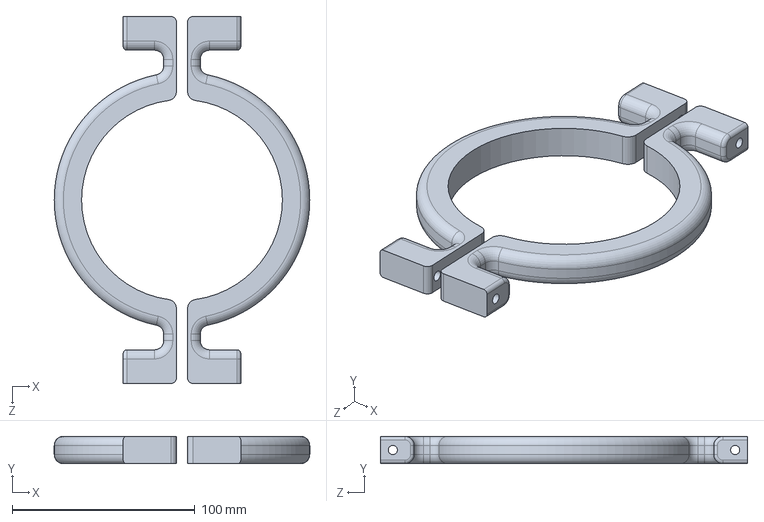
[picture p43: CAD file, 2026-11-10]
cad/solidworks/Parts/Cann_Brackets.SLDPRT
140.0 x 15.0 x 201.1 mm
