AUV-VITP/isonavi-rov/cad/solidworks/ASSem/Gripper/connctor small.SLDPRT

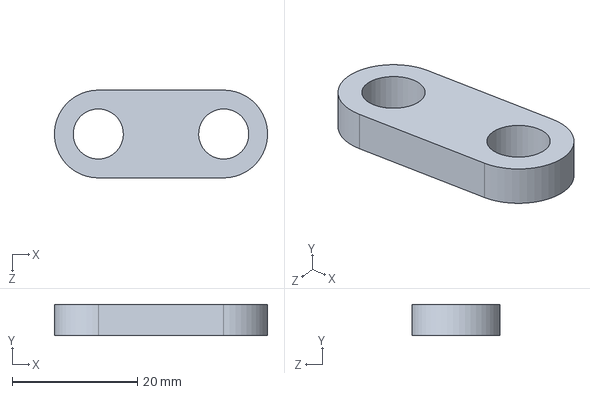
[picture p44: CAD file, 2026-11-10]
cad/solidworks/ASSem/Gripper/connctor small.SLDPRT
34.0 x 5.00 x 14.0 mm
