AUV-VITP/isonavi-rov/cad/solidworks/Parts/CAN-001.SLDPRT

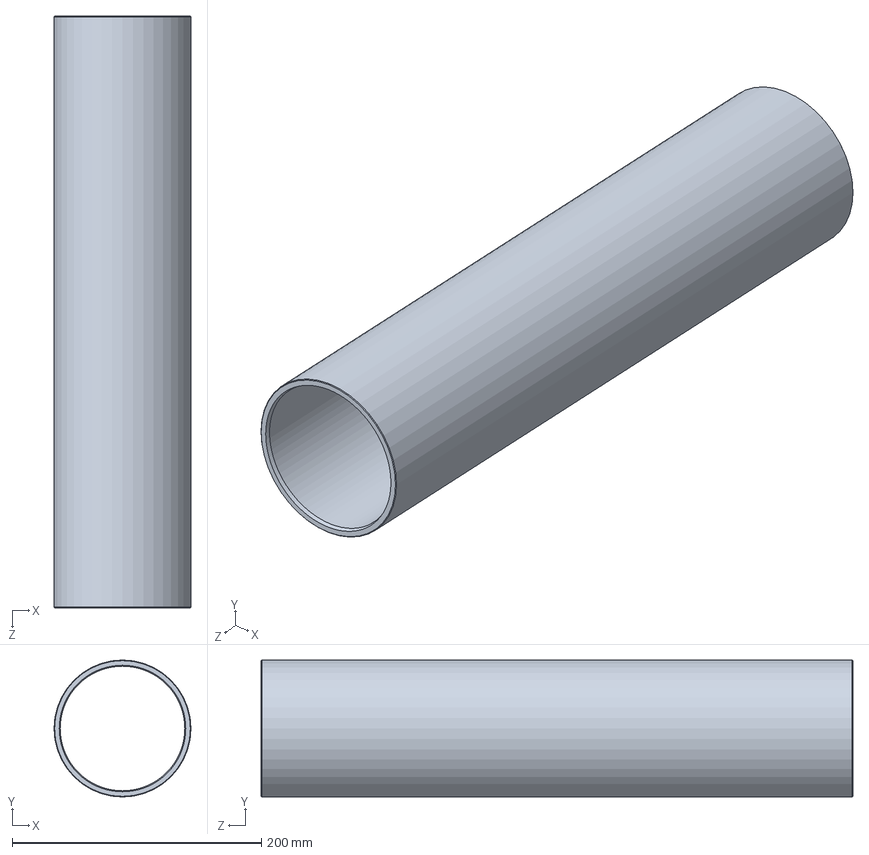
[picture p45: CAD file, 2026-11-10]
cad/solidworks/Parts/CAN-001.SLDPRT
110.0 x 110.0 x 475.0 mm
