AUV-VITP/isonavi-rov/cad/solidworks/ASSem/Gripper/connctor Big.SLDPRT

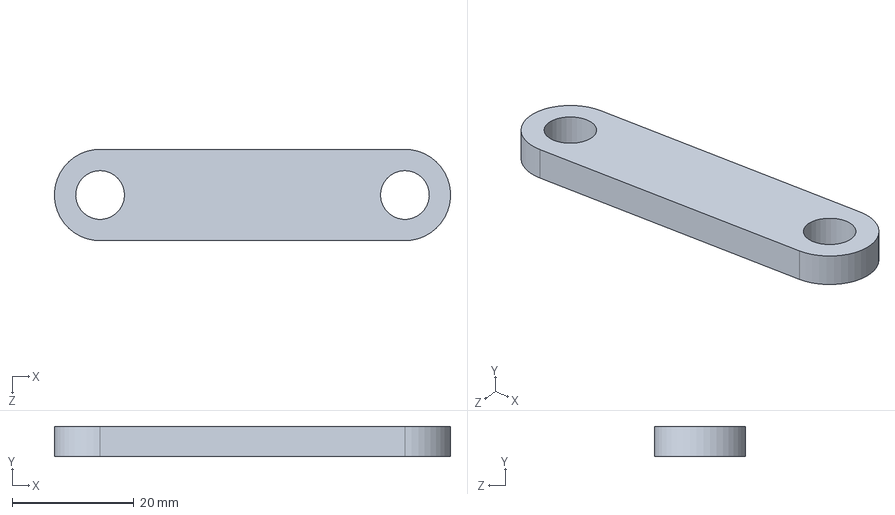
[picture p46: CAD file, 2026-11-10]
cad/solidworks/ASSem/Gripper/connctor Big.SLDPRT
65.0 x 5.00 x 15.0 mm
