AUV-VITP/isonavi-rov/cad/solidworks/Parts/Sled_O_Ring.SLDPRT

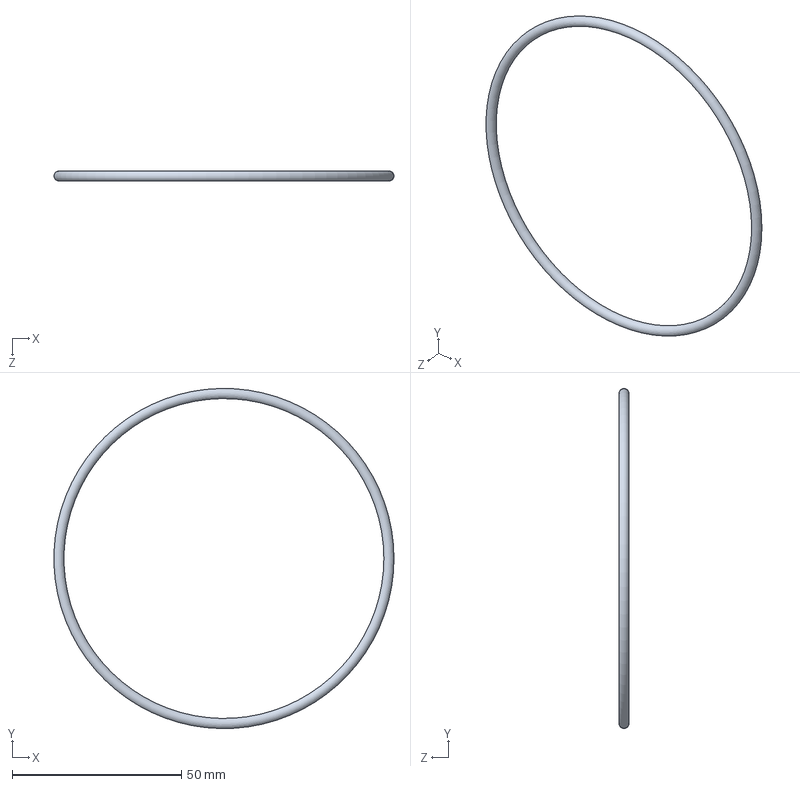
[picture p47: CAD file, 2026-11-10]
cad/solidworks/Parts/Sled_O_Ring.SLDPRT
100.4 x 100.4 x 3.00 mm
