AUV-VITP/isonavi-rov/cad/solidworks/Parts/CAN-004_Spine.SLDPRT

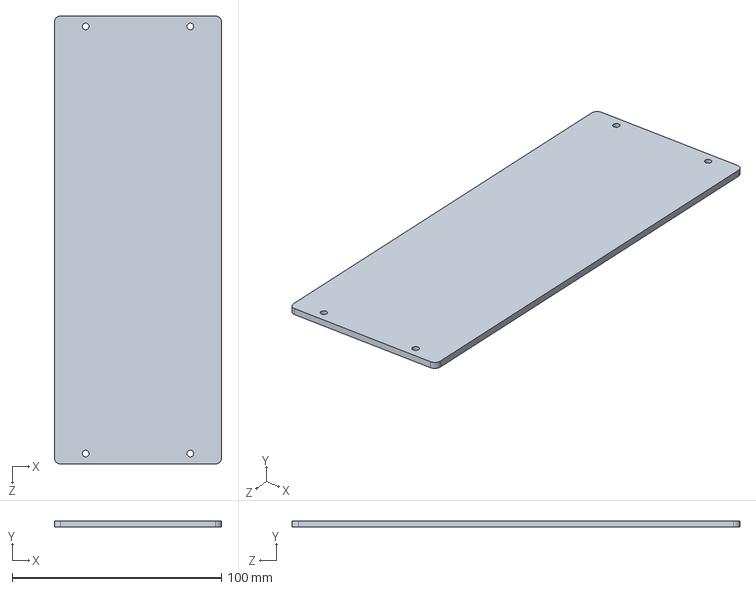
[picture p48: CAD file, 2026-11-10]
cad/solidworks/Parts/CAN-004_Spine.SLDPRT
80.0 x 3.00 x 214.0 mm
