AUV-VITP/isonavi-rov/cad/solidworks/ASSem/Gripper/Bracket.SLDPRT

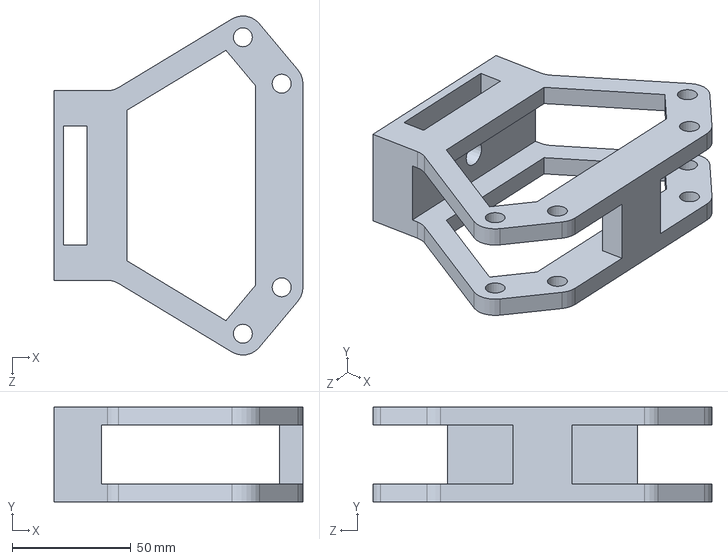
[picture p49: CAD file, 2026-11-10]
cad/solidworks/ASSem/Gripper/Bracket.SLDPRT
105.0 x 40.0 x 143.0 mm
