AUV-VITP/isonavi-rov/cad/solidworks/Parts/CAN-004_Spine - BATT.SLDPRT

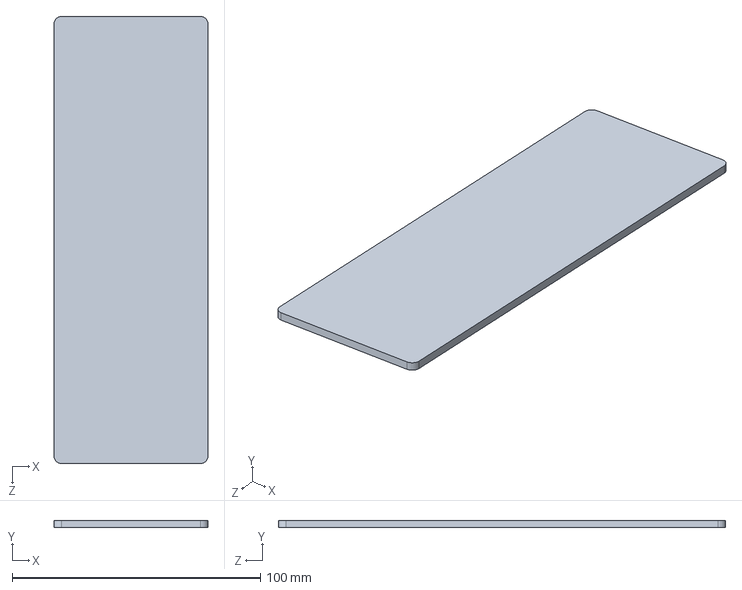
[picture p50: CAD file, 2026-11-10]
cad/solidworks/Parts/CAN-004_Spine - BATT.SLDPRT
62.0 x 3.00 x 180.0 mm
