AUV-VITP/isonavi-rov/cad/solidworks/ASSem/Gripper/Jaw.SLDPRT

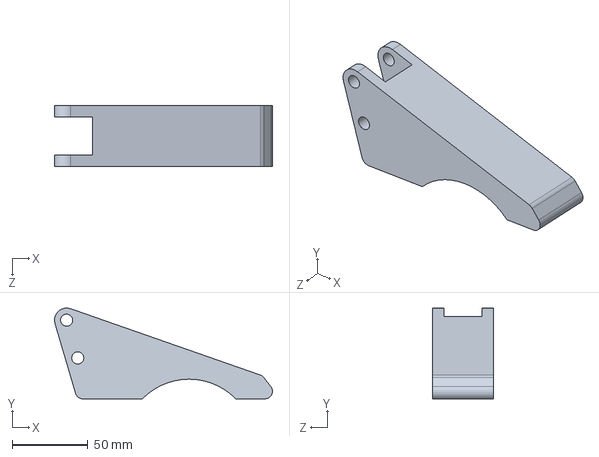
[picture p51: CAD file, 2026-11-10]
cad/solidworks/ASSem/Gripper/Jaw.SLDPRT
143.7 x 59.8 x 40.0 mm
