AUV-VITP/isonavi-rov/cad/solidworks/Parts/Supports.SLDPRT

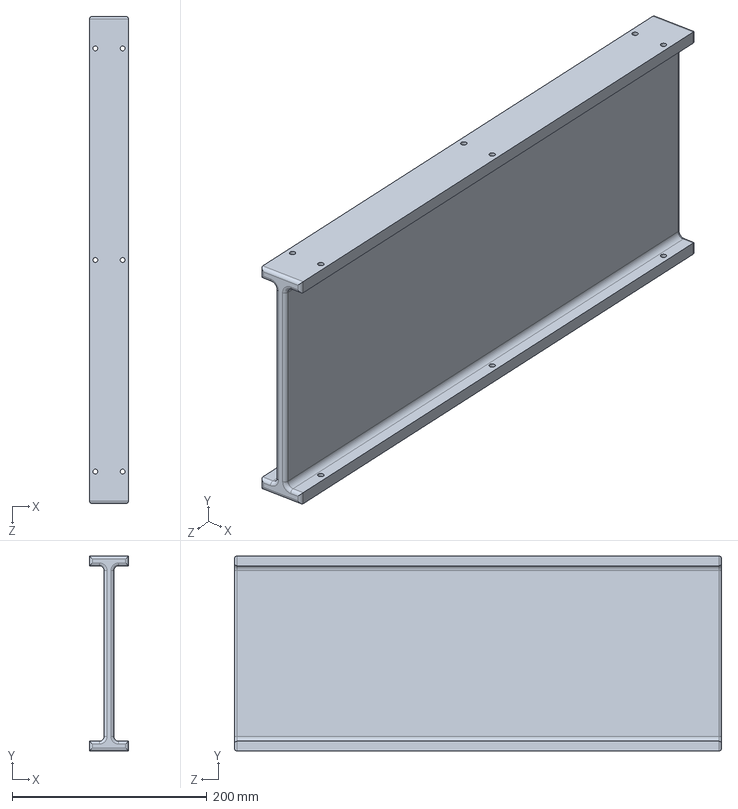
[picture p52: CAD file, 2026-11-10]
cad/solidworks/Parts/Supports.SLDPRT
40.0 x 200.0 x 500.0 mm
