AUV-VITP/isonavi-rov/cad/solidworks/ASSem/Gripper/crank.SLDPRT

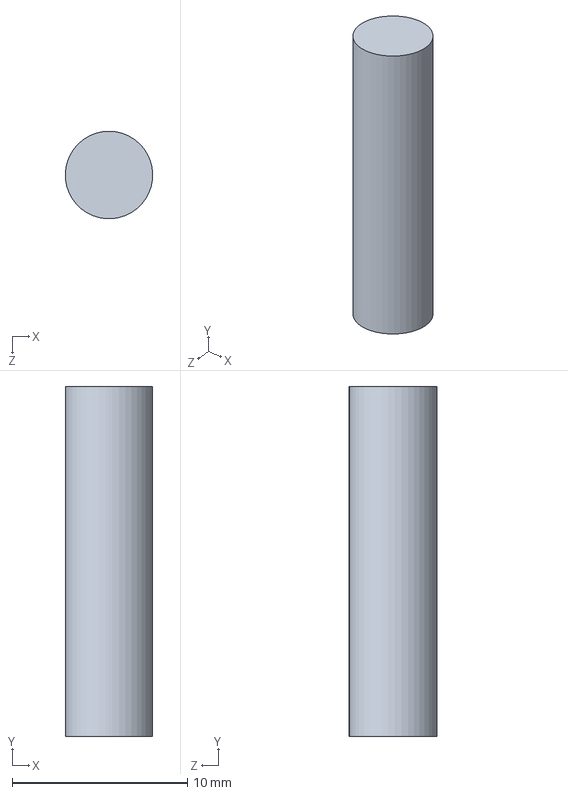
[picture p53: CAD file, 2026-11-10]
cad/solidworks/ASSem/Gripper/crank.SLDPRT
5.00 x 20.0 x 5.00 mm
