AUV-VITP/isonavi-rov/cad/solidworks/Parts/Oring_faceseal.SLDPRT

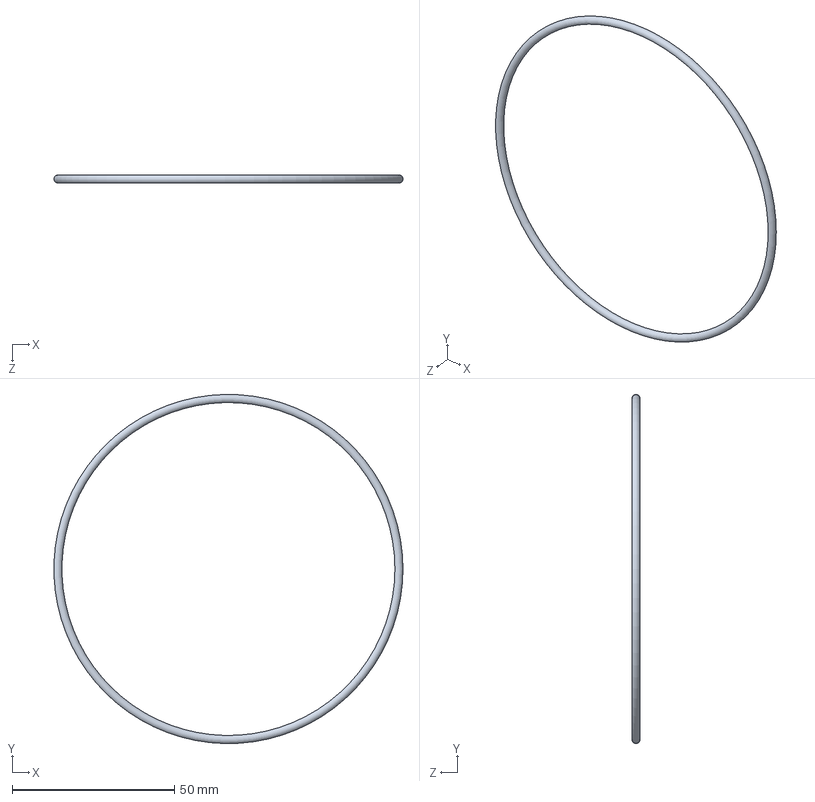
[picture p54: CAD file, 2026-11-10]
cad/solidworks/Parts/Oring_faceseal.SLDPRT
107.5 x 107.5 x 2.50 mm
