AUV-VITP/isonavi-rov/cad/solidworks/ASSem/Gripper/pin3.SLDPRT

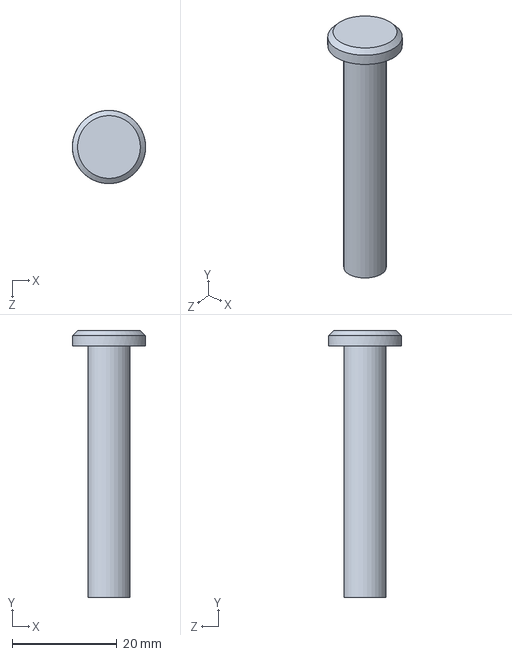
[picture p55: CAD file, 2026-11-10]
cad/solidworks/ASSem/Gripper/pin3.SLDPRT
14.0 x 51.0 x 14.0 mm
