AUV-VITP/isonavi-rov/cad/solidworks/Parts/CAN-003_Cap.SLDPRT

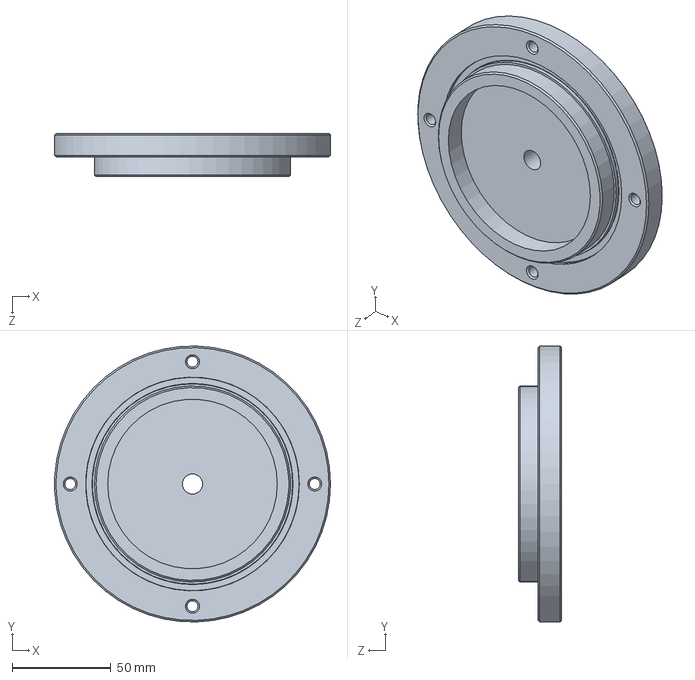
[picture p56: CAD file, 2026-11-10]
cad/solidworks/Parts/CAN-003_Cap.SLDPRT
140.0 x 139.9 x 22.0 mm
