AUV-VITP/isonavi-rov/cad/solidworks/ASSem/Gripper/pin4.SLDPRT

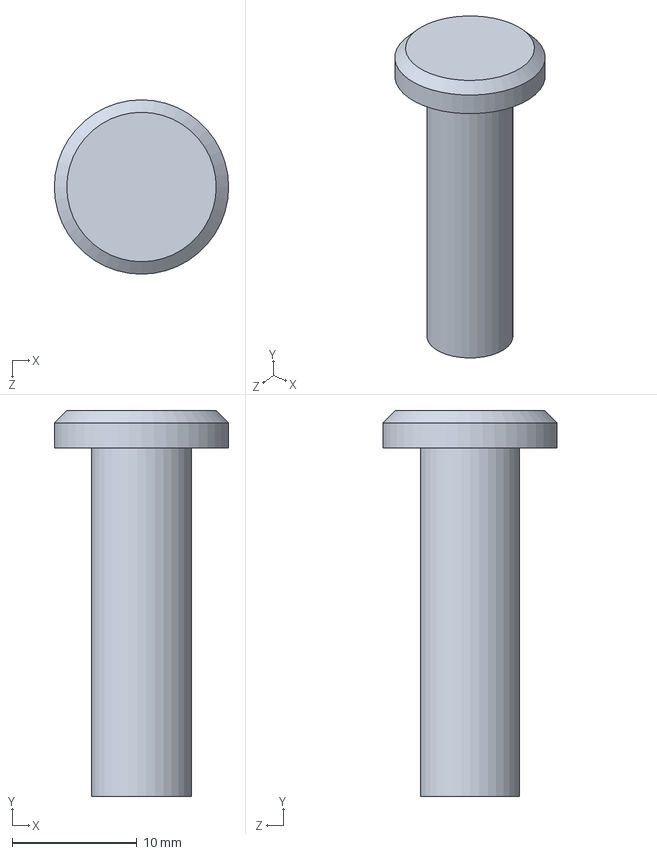
[picture p57: CAD file, 2026-11-10]
cad/solidworks/ASSem/Gripper/pin4.SLDPRT
14.0 x 31.0 x 14.0 mm
