AUV-VITP/isonavi-rov/cad/solidworks/ASSem/enclosure.SLDASM

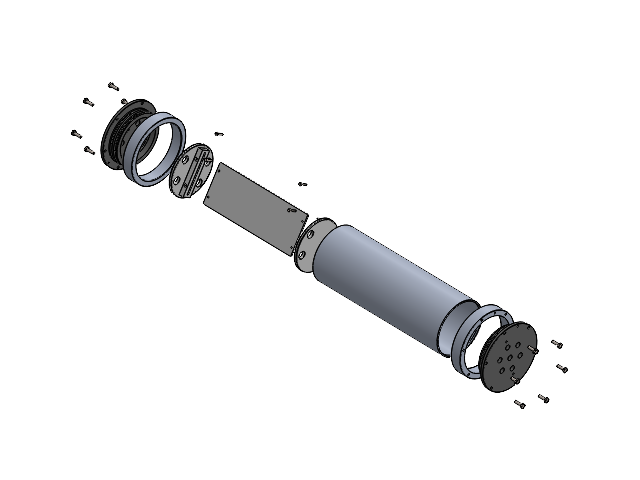
[picture p58: CAD file, 2026-11-10]
cad/solidworks/ASSem/enclosure.SLDASM
CAN-005_Disc x 2
CAN-004_Spine
socket head cap screw_am x 4
CAN-001
CAN-002_Collar x 2
CAN-003_Plug x 2
formed hex screw_am x 12
