AUV-VITP/isonavi-rov/cad/solidworks/ASSem/FRAME.SLDASM

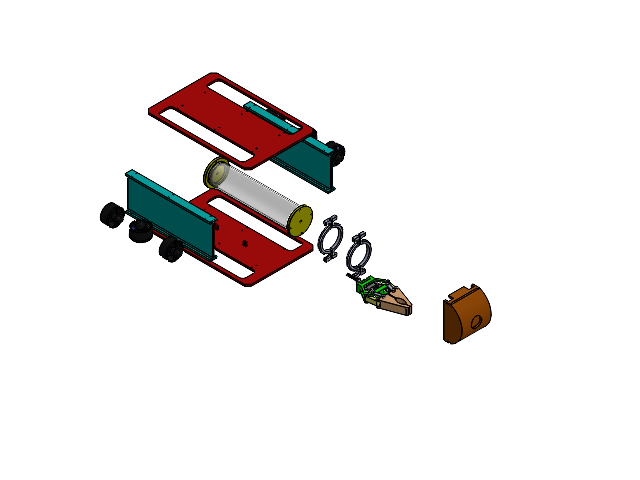
[picture p59: CAD file, 2026-11-10]
cad/solidworks/ASSem/FRAME.SLDASM
FRAME 1 x 2
Cann_Brackets x 2
CAN-001
CAN-003_Cap x 2
Supports x 2
CRUOCHMSTI ANSI B18.6.3 - 3-56 UNF x 1_8 Steel Grade 2 Plain.step x 24
eBom-FreeParts.step x 6
Bracket
Jaw Connctor x 2
Jaw x 2
connctor Big x 2
Slider
connctor small x 2
shift
Nut x 12
pin2 x 4
pin3 x 4
pin4 x 2
pin1 x 2
CAM-Mount
