AUV-VITP/isonavi-rov/cad/solidworks/ASSem/ELEC-SLED.SLDASM

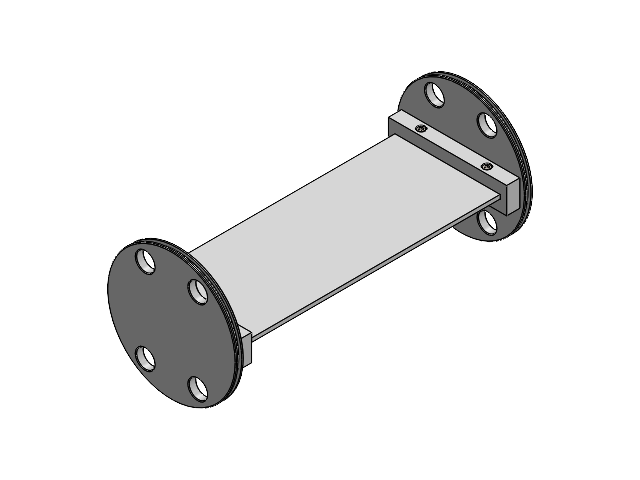
[picture p60: CAD file, 2026-11-10]
cad/solidworks/ASSem/ELEC-SLED.SLDASM
CAN-005_Disc x 2
CAN-004_Spine
socket head cap screw_am x 4
