AUV-VITP/isonavi-rov/cad/solidworks/ASSem/M080 Thruster.SLDASM

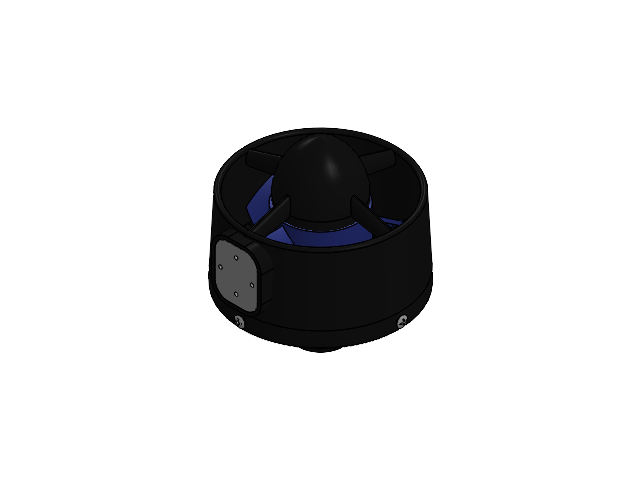
[picture p61: CAD file, 2026-11-10]
cad/solidworks/ASSem/M080 Thruster.SLDASM
CRUOCHMSTI ANSI B18.6.3 - 3-56 UNF x 1_8 Steel Grade 2 Plain.step x 4
eBom-FreeParts.step
