AUV-VITP/isonavi-rov/(list of files, cad)

Other CAD files:
simulation/vehicle/isonavi_rov.step
cad/solidworks/ASSem/Gripper/Assem1.SLDPRT
cad/solidworks/ASSem/Gripper/Nut.SLDPRT
cad/solidworks/Drawings/FRAME.SLDDRW
