AUV-VITP/isonavi-rov/ros/isonavi_rov_description/models/isonavi_rov/model.sdf

<?xml version="1.0"?>
<!-- Generated by ros/isonavi_rov_description/make_model.py from simulation/vehicle/rov_budget.json. Do not edit. -->
<sdf version="1.11">
  <model name="isonavi_rov">
    <link name="base_link">
      <inertial>
        <mass>10.0824</mass>
        <inertia>
          <ixx>0.172814</ixx>
          <ixy>0</ixy>
          <ixz>2.08749e-05</ixz>
          <iyy>0.271242</iyy>
          <iyz>0</iyz>
          <izz>0.31658</izz>
        </inertia>
        <fluid_added_mass>
          <xx>5.14042</xx>
          <yy>5.75468</yy>
          <zz>15.098</zz>
          <pp>0.132545</pp>
          <qq>0.0946752</qq>
          <rr>0.155688</rr>
        </fluid_added_mass>
      </inertial>
      <visual name="visual_0">
        <pose>0.00193175 0 0.00701557 0 0 0</pose>
        <geometry><mesh><uri>model://isonavi_rov/meshes/part_0.stl</uri><scale>0.001 0.001 0.001</scale></mesh></geometry>
        <material><ambient>0.16 0.17 0.2 1</ambient><diffuse>0.16 0.17 0.2 1</diffuse></material>
      </visual>
      <visual name="visual_1">
        <pose>0.00193175 0 0.00701557 0 0 0</pose>
        <geometry><mesh><uri>model://isonavi_rov/meshes/part_1.stl</uri><scale>0.001 0.001 0.001</scale></mesh></geometry>
        <material><ambient>0.2 0.22 0.27 1</ambient><diffuse>0.2 0.22 0.27 1</diffuse></material>
      </visual>
      <visual name="visual_2">
        <pose>0.00193175 0 0.00701557 0 0 0</pose>
        <geometry><mesh><uri>model://isonavi_rov/meshes/part_2.stl</uri><scale>0.001 0.001 0.001</scale></mesh></geometry>
        <material><ambient>0.34 0.35 0.4 1</ambient><diffuse>0.34 0.35 0.4 1</diffuse></material>
      </visual>
      <visual name="visual_3">
        <pose>0.00193175 0 0.00701557 0 0 0</pose>
        <geometry><mesh><uri>model://isonavi_rov/meshes/part_3.stl</uri><scale>0.001 0.001 0.001</scale></mesh></geometry>
        <material><ambient>0.62 0.64 0.68 1</ambient><diffuse>0.62 0.64 0.68 1</diffuse></material>
      </visual>
      <visual name="visual_4">
        <pose>0.00193175 0 0.00701557 0 0 0</pose>
        <geometry><mesh><uri>model://isonavi_rov/meshes/part_4.stl</uri><scale>0.001 0.001 0.001</scale></mesh></geometry>
        <material><ambient>0.7 0.82 0.9 1</ambient><diffuse>0.7 0.82 0.9 1</diffuse></material>
      </visual>
      <visual name="visual_5">
        <pose>0.00193175 0 0.00701557 0 0 0</pose>
        <geometry><mesh><uri>model://isonavi_rov/meshes/part_5.stl</uri><scale>0.001 0.001 0.001</scale></mesh></geometry>
        <material><ambient>0.75 0.12 0.1 1</ambient><diffuse>0.75 0.12 0.1 1</diffuse></material>
      </visual>
      <visual name="visual_6">
        <pose>0.00193175 0 0.00701557 0 0 0</pose>
        <geometry><mesh><uri>model://isonavi_rov/meshes/part_6.stl</uri><scale>0.001 0.001 0.001</scale></mesh></geometry>
        <material><ambient>0.86 0.55 0.16 1</ambient><diffuse>0.86 0.55 0.16 1</diffuse></material>
      </visual>
      <visual name="visual_7">
        <pose>0.00193175 0 0.00701557 0 0 0</pose>
        <geometry><mesh><uri>model://isonavi_rov/meshes/part_7.stl</uri><scale>0.001 0.001 0.001</scale></mesh></geometry>
        <material><ambient>0.93 0.8 0.25 1</ambient><diffuse>0.93 0.8 0.25 1</diffuse></material>
      </visual>
      <visual name="visual_8">
        <pose>0.00193175 0 0.00701557 0 0 0</pose>
        <geometry><mesh><uri>model://isonavi_rov/meshes/part_8.stl</uri><scale>0.001 0.001 0.001</scale></mesh></geometry>
        <material><ambient>0.95 0.95 0.85 1</ambient><diffuse>0.95 0.95 0.85 1</diffuse></material>
      </visual>
      <collision name="side_plate_port">
        <pose>0.00193175 0.2169 0.00701557 0 0 0</pose>
        <geometry><box><size>0.6 0.0062 0.33</size></box></geometry>
      </collision>
      <collision name="side_plate_stbd">
        <pose>0.00193175 -0.2169 0.00701557 0 0 0</pose>
        <geometry><box><size>0.6 0.0062 0.33</size></box></geometry>
      </collision>
      <collision name="cross_member_1">
        <pose>0.221932 0 0.127016 0 0 0</pose>
        <geometry><box><size>0.04 0.42 0.01</size></box></geometry>
      </collision>
      <collision name="cross_member_2">
        <pose>-0.218068 0 0.127016 0 0 0</pose>
        <geometry><box><size>0.04 0.42 0.01</size></box></geometry>
      </collision>
      <collision name="cross_member_3">
        <pose>0.221932 0 -0.122984 0 0 0</pose>
        <geometry><box><size>0.04 0.42 0.01</size></box></geometry>
      </collision>
      <collision name="cross_member_4">
        <pose>-0.218068 0 -0.122984 0 0 0</pose>
        <geometry><box><size>0.04 0.42 0.01</size></box></geometry>
      </collision>
      <collision name="skid_port">
        <pose>0.00193175 0.15 -0.147984 0 0 0</pose>
        <geometry><box><size>0.57 0.02 0.02</size></box></geometry>
      </collision>
      <collision name="skid_stbd">
        <pose>0.00193175 -0.15 -0.147984 0 0 0</pose>
        <geometry><box><size>0.57 0.02 0.02</size></box></geometry>
      </collision>
      <collision name="hull">
        <pose>0.0319317 0 0.0470156 0 1.5708 0</pose>
        <geometry><cylinder><radius>0.057</radius><length>0.3</length></cylinder></geometry>
      </collision>
      <collision name="end_cap_rear">
        <pose>-0.126068 0 0.0470156 0 1.5708 0</pose>
        <geometry><cylinder><radius>0.062</radius><length>0.016</length></cylinder></geometry>
      </collision>
      <collision name="end_cap_front">
        <pose>0.189932 0 0.0470156 0 1.5708 0</pose>
        <geometry><cylinder><radius>0.062</radius><length>0.016</length></cylinder></geometry>
      </collision>
      <collision name="foam">
        <pose>-0.0541722 0 0.152016 0 0 0</pose>
        <geometry><box><size>0.31003 0.24 0.032</size></box></geometry>
      </collision>
      <collision name="ballast">
        <pose>0.00193175 0 -0.142984 0 0 0</pose>
        <geometry><box><size>0.15 0.06 0.0116175</size></box></geometry>
      </collision>
      <collision name="lamp_port">
        <pose>0.231932 0.18 0.0470156 0 1.5708 0</pose>
        <geometry><cylinder><radius>0.018</radius><length>0.06</length></cylinder></geometry>
      </collision>
      <collision name="lamp_stbd">
        <pose>0.231932 -0.18 0.0470156 0 1.5708 0</pose>
        <geometry><cylinder><radius>0.018</radius><length>0.06</length></cylinder></geometry>
      </collision>
      <collision name="probe">
        <pose>0.301932 0 -0.0529844 0 1.5708 0</pose>
        <geometry><cylinder><radius>0.005</radius><length>0.12</length></cylinder></geometry>
      </collision>
      <collision name="probe_bracket">
        <pose>0.251932 0 -0.0874844 0 0 0</pose>
        <geometry><box><size>0.02 0.02 0.059</size></box></geometry>
      </collision>
      <collision name="kill_switch">
        <pose>-0.218068 0.15 0.142016 0 0 0</pose>
        <geometry><cylinder><radius>0.015</radius><length>0.02</length></cylinder></geometry>
      </collision>
      <collision name="tether_termination">
        <pose>-0.278068 0 -0.00298443 0 1.5708 0</pose>
        <geometry><cylinder><radius>0.015</radius><length>0.04</length></cylinder></geometry>
      </collision>
      <collision name="tow_post">
        <pose>-0.218068 0 0.00201557 0 0 0</pose>
        <geometry><box><size>0.03 0.01 0.24</size></box></geometry>
      </collision>
      <collision name="tow_bracket">
        <pose>-0.245568 0 -0.00298443 0 0 0</pose>
        <geometry><box><size>0.025 0.02 0.02</size></box></geometry>
      </collision>
      <collision name="displacement">
        <pose>0.00311667 -0.00177429 0.0244224 0 0 0</pose>
        <geometry><sphere><radius>0.0658335</radius></sphere></geometry>
        <surface><contact><collide_bitmask>0x0000</collide_bitmask></contact></surface>
      </collision>
      <sensor name="camera" type="camera">
        <pose>0.19 0 0.04 0 0 0</pose>
        <always_on>true</always_on>
        <update_rate>10</update_rate>
        <topic>/model/isonavi_rov/camera/image</topic>
        <camera>
          <horizontal_fov>1.39626</horizontal_fov>
          <image><width>640</width><height>480</height><format>R8G8B8</format></image>
          <clip><near>0.05</near><far>12</far></clip>
          <noise><type>gaussian</type><mean>0</mean><stddev>0.004</stddev></noise>
        </camera>
      </sensor>
      <sensor name="imu" type="imu">
        <always_on>true</always_on>
        <update_rate>100</update_rate>
        <topic>/model/isonavi_rov/imu</topic>
        <imu>
          <angular_velocity><x><noise type="gaussian"><stddev>0.0017</stddev></noise></x><y><noise type="gaussian"><stddev>0.0017</stddev></noise></y><z><noise type="gaussian"><stddev>0.0017</stddev></noise></z></angular_velocity>
          <linear_acceleration><x><noise type="gaussian"><stddev>0.02</stddev></noise></x><y><noise type="gaussian"><stddev>0.02</stddev></noise></y><z><noise type="gaussian"><stddev>0.02</stddev></noise></z></linear_acceleration>
        </imu>
      </sensor>
      <light name="light_port" type="spot">
        <pose>0.26 0.18 0.04 0 -1.5708 0</pose>
        <diffuse>1 0.97 0.9 1</diffuse><specular>0.2 0.2 0.2 1</specular>
        <attenuation><range>12</range><constant>0.2</constant><linear>0</linear><quadratic>0.15</quadratic></attenuation>
        <spot><inner_angle>1.14372</inner_angle><outer_angle>2.28744</outer_angle><falloff>1</falloff></spot>
        <cast_shadows>false</cast_shadows>
      </light>
      <light name="light_stbd" type="spot">
        <pose>0.26 -0.18 0.04 0 -1.5708 0</pose>
        <diffuse>1 0.97 0.9 1</diffuse><specular>0.2 0.2 0.2 1</specular>
        <attenuation><range>12</range><constant>0.2</constant><linear>0</linear><quadratic>0.15</quadratic></attenuation>
        <spot><inner_angle>1.14372</inner_angle><outer_angle>2.28744</outer_angle><falloff>1</falloff></spot>
        <cast_shadows>false</cast_shadows>
      </light>
    </link>
    <link name="thruster_1">
      <pose>0.216932 0.15 -0.0529844 0 0 0.785398</pose>
      <inertial><mass>0.05</mass><inertia><ixx>1e-5</ixx><iyy>1e-5</iyy><izz>1e-5</izz></inertia></inertial>
    </link>
    <joint name="thruster_1_joint" type="revolute">
      <parent>base_link</parent>
      <child>thruster_1</child>
      <axis><xyz>1 0 0</xyz><limit><effort>50</effort><velocity>600</velocity></limit></axis>
    </joint>
    <plugin filename="gz-sim-thruster-system" name="gz::sim::systems::Thruster">
      <joint_name>thruster_1_joint</joint_name>
      <thrust_coefficient>0.0101321</thrust_coefficient>
      <fluid_density>1000</fluid_density>
      <propeller_diameter>0.076</propeller_diameter>
      <velocity_control>true</velocity_control>
      <max_thrust_cmd>30</max_thrust_cmd>
      <min_thrust_cmd>-30</min_thrust_cmd>
    </plugin>
    <link name="thruster_2">
      <pose>0.216932 -0.15 -0.0529844 0 0 -0.785398</pose>
      <inertial><mass>0.05</mass><inertia><ixx>1e-5</ixx><iyy>1e-5</iyy><izz>1e-5</izz></inertia></inertial>
    </link>
    <joint name="thruster_2_joint" type="revolute">
      <parent>base_link</parent>
      <child>thruster_2</child>
      <axis><xyz>1 0 0</xyz><limit><effort>50</effort><velocity>600</velocity></limit></axis>
    </joint>
    <plugin filename="gz-sim-thruster-system" name="gz::sim::systems::Thruster">
      <joint_name>thruster_2_joint</joint_name>
      <thrust_coefficient>0.0101321</thrust_coefficient>
      <fluid_density>1000</fluid_density>
      <propeller_diameter>0.076</propeller_diameter>
      <velocity_control>true</velocity_control>
      <max_thrust_cmd>30</max_thrust_cmd>
      <min_thrust_cmd>-30</min_thrust_cmd>
    </plugin>
    <link name="thruster_3">
      <pose>-0.213068 0.15 -0.0529844 0 0 -0.785398</pose>
      <inertial><mass>0.05</mass><inertia><ixx>1e-5</ixx><iyy>1e-5</iyy><izz>1e-5</izz></inertia></inertial>
    </link>
    <joint name="thruster_3_joint" type="revolute">
      <parent>base_link</parent>
      <child>thruster_3</child>
      <axis><xyz>1 0 0</xyz><limit><effort>50</effort><velocity>600</velocity></limit></axis>
    </joint>
    <plugin filename="gz-sim-thruster-system" name="gz::sim::systems::Thruster">
      <joint_name>thruster_3_joint</joint_name>
      <thrust_coefficient>0.0101321</thrust_coefficient>
      <fluid_density>1000</fluid_density>
      <propeller_diameter>0.076</propeller_diameter>
      <velocity_control>true</velocity_control>
      <max_thrust_cmd>30</max_thrust_cmd>
      <min_thrust_cmd>-30</min_thrust_cmd>
    </plugin>
    <link name="thruster_4">
      <pose>-0.213068 -0.15 -0.0529844 0 0 0.785398</pose>
      <inertial><mass>0.05</mass><inertia><ixx>1e-5</ixx><iyy>1e-5</iyy><izz>1e-5</izz></inertia></inertial>
    </link>
    <joint name="thruster_4_joint" type="revolute">
      <parent>base_link</parent>
      <child>thruster_4</child>
      <axis><xyz>1 0 0</xyz><limit><effort>50</effort><velocity>600</velocity></limit></axis>
    </joint>
    <plugin filename="gz-sim-thruster-system" name="gz::sim::systems::Thruster">
      <joint_name>thruster_4_joint</joint_name>
      <thrust_coefficient>0.0101321</thrust_coefficient>
      <fluid_density>1000</fluid_density>
      <propeller_diameter>0.076</propeller_diameter>
      <velocity_control>true</velocity_control>
      <max_thrust_cmd>30</max_thrust_cmd>
      <min_thrust_cmd>-30</min_thrust_cmd>
    </plugin>
    <link name="thruster_5">
      <pose>0.131932 0.155 0.107016 0 -1.5708 0</pose>
      <inertial><mass>0.05</mass><inertia><ixx>1e-5</ixx><iyy>1e-5</iyy><izz>1e-5</izz></inertia></inertial>
    </link>
    <joint name="thruster_5_joint" type="revolute">
      <parent>base_link</parent>
      <child>thruster_5</child>
      <axis><xyz>1 0 0</xyz><limit><effort>50</effort><velocity>600</velocity></limit></axis>
    </joint>
    <plugin filename="gz-sim-thruster-system" name="gz::sim::systems::Thruster">
      <joint_name>thruster_5_joint</joint_name>
      <thrust_coefficient>0.0101321</thrust_coefficient>
      <fluid_density>1000</fluid_density>
      <propeller_diameter>0.076</propeller_diameter>
      <velocity_control>true</velocity_control>
      <max_thrust_cmd>30</max_thrust_cmd>
      <min_thrust_cmd>-30</min_thrust_cmd>
    </plugin>
    <link name="thruster_6">
      <pose>0.131932 -0.155 0.107016 0 -1.5708 0</pose>
      <inertial><mass>0.05</mass><inertia><ixx>1e-5</ixx><iyy>1e-5</iyy><izz>1e-5</izz></inertia></inertial>
    </link>
    <joint name="thruster_6_joint" type="revolute">
      <parent>base_link</parent>
      <child>thruster_6</child>
      <axis><xyz>1 0 0</xyz><limit><effort>50</effort><velocity>600</velocity></limit></axis>
    </joint>
    <plugin filename="gz-sim-thruster-system" name="gz::sim::systems::Thruster">
      <joint_name>thruster_6_joint</joint_name>
      <thrust_coefficient>0.0101321</thrust_coefficient>
      <fluid_density>1000</fluid_density>
      <propeller_diameter>0.076</propeller_diameter>
      <velocity_control>true</velocity_control>
      <max_thrust_cmd>30</max_thrust_cmd>
      <min_thrust_cmd>-30</min_thrust_cmd>
    </plugin>
    <link name="thruster_7">
      <pose>-0.128068 0.155 0.107016 0 -1.5708 0</pose>
      <inertial><mass>0.05</mass><inertia><ixx>1e-5</ixx><iyy>1e-5</iyy><izz>1e-5</izz></inertia></inertial>
    </link>
    <joint name="thruster_7_joint" type="revolute">
      <parent>base_link</parent>
      <child>thruster_7</child>
      <axis><xyz>1 0 0</xyz><limit><effort>50</effort><velocity>600</velocity></limit></axis>
    </joint>
    <plugin filename="gz-sim-thruster-system" name="gz::sim::systems::Thruster">
      <joint_name>thruster_7_joint</joint_name>
      <thrust_coefficient>0.0101321</thrust_coefficient>
      <fluid_density>1000</fluid_density>
      <propeller_diameter>0.076</propeller_diameter>
      <velocity_control>true</velocity_control>
      <max_thrust_cmd>30</max_thrust_cmd>
      <min_thrust_cmd>-30</min_thrust_cmd>
    </plugin>
    <link name="thruster_8">
      <pose>-0.128068 -0.155 0.107016 0 -1.5708 0</pose>
      <inertial><mass>0.05</mass><inertia><ixx>1e-5</ixx><iyy>1e-5</iyy><izz>1e-5</izz></inertia></inertial>
    </link>
    <joint name="thruster_8_joint" type="revolute">
      <parent>base_link</parent>
      <child>thruster_8</child>
      <axis><xyz>1 0 0</xyz><limit><effort>50</effort><velocity>600</velocity></limit></axis>
    </joint>
    <plugin filename="gz-sim-thruster-system" name="gz::sim::systems::Thruster">
      <joint_name>thruster_8_joint</joint_name>
      <thrust_coefficient>0.0101321</thrust_coefficient>
      <fluid_density>1000</fluid_density>
      <propeller_diameter>0.076</propeller_diameter>
      <velocity_control>true</velocity_control>
      <max_thrust_cmd>30</max_thrust_cmd>
      <min_thrust_cmd>-30</min_thrust_cmd>
    </plugin>
    <plugin filename="gz-sim-hydrodynamics-system" name="gz::sim::systems::Hydrodynamics">
      <link_name>base_link</link_name>
      <disable_added_mass>true</disable_added_mass>
      <xU>-13.6203</xU>
      <yV>0</yV>
      <zW>-33.1538</zW>
      <kP>0</kP>
      <mQ>-1.09779</mQ>
      <nR>0</nR>
      <xUabsU>-140.179</xUabsU>
      <yVabsV>-370.148</yVabsV>
      <zWabsW>-190.886</zWabsW>
      <kPabsP>-1.63296</kPabsP>
      <mQabsQ>-0.644951</mQabsQ>
      <nRabsR>-2.05835</nRabsR>
    </plugin>
  </model>
</sdf>
