AUV-VITP/isonavi-rov/(commit log)

2026-10-23 add the pool arena and the camera model
2026-10-23 add the ros 2 layer, the safety chain and the bill of materials
2026-10-23 match the thruster motor to its propeller
2026-10-23 close the loop on the camera and check the vehicle against its cad
2026-10-23 blend the pilot and the camera by their errors
2026-10-23 need both gate posts in frame and run the shared blend on the vehicle
2026-10-24 tow point at cg height, thermal bridge, +5 N buoyancy and a 54 V supply
2026-11-09 keyboard teleop, ground station, operator video, river worlds and a real flood current
2026-11-10 team cad, power study, architecture and gazebo session video; readme follows the six thruster build
2026-11-10 readme and figures follow the final deck: six thruster architecture, working principle, power calculations, existing solutions, applications, references
2026-11-10 isonavi-rov only: cad holds the team solidworks design, old isonavi-1 code, data and documents removed, simulation vehicle moved to simulation/vehicle, working principle from the final deck
